scottdube/animatronic-eyes/docs/scope/2026-09-25-wallwart-1V-step.jpg

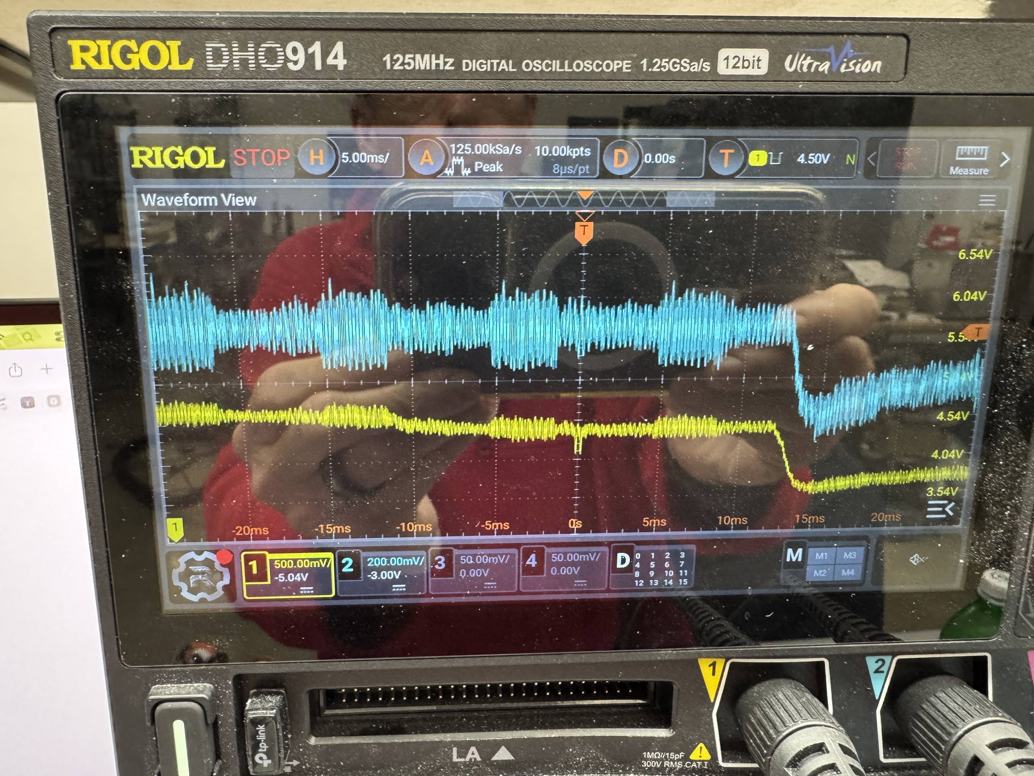
docs/scope/2026-09-25-wallwart-1V-step.jpg
