scottdube/animatronic-eyes/docs/board.jpg

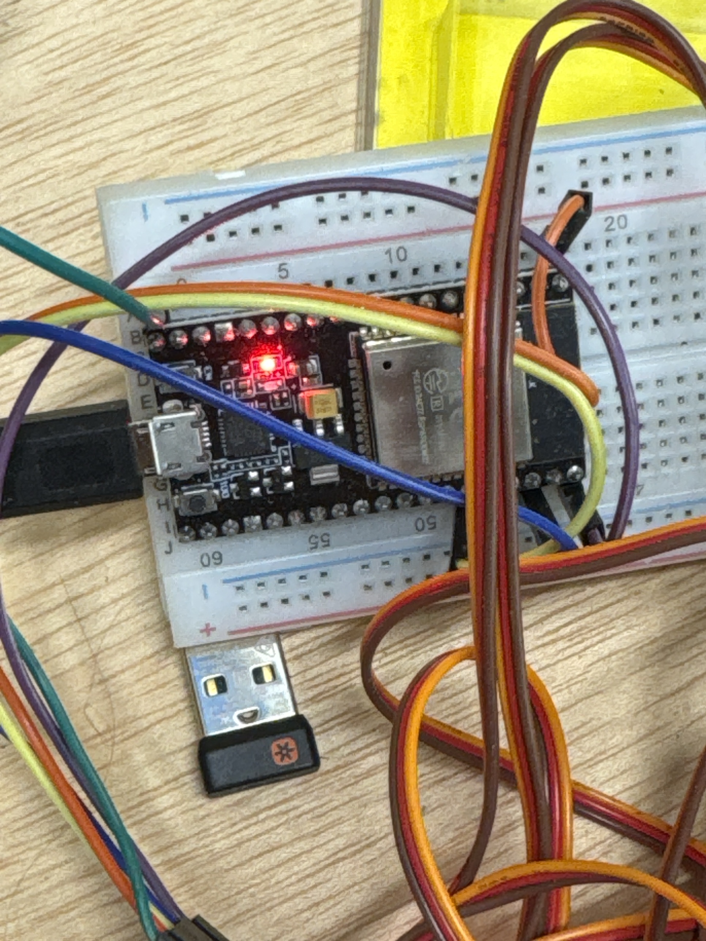
docs/board.jpg
