scottdube/animatronic-eyes/docs/board-pca9685.jpg

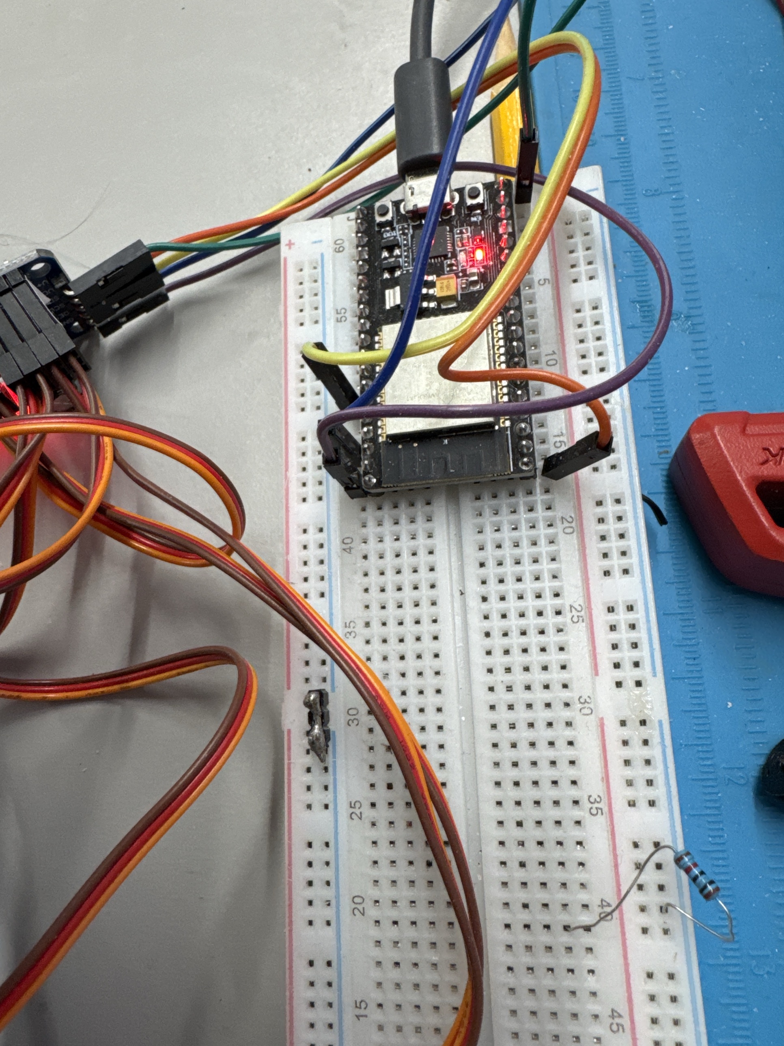
docs/board-pca9685.jpg
