scottdube/animatronic-eyes/docs/controller.jpg

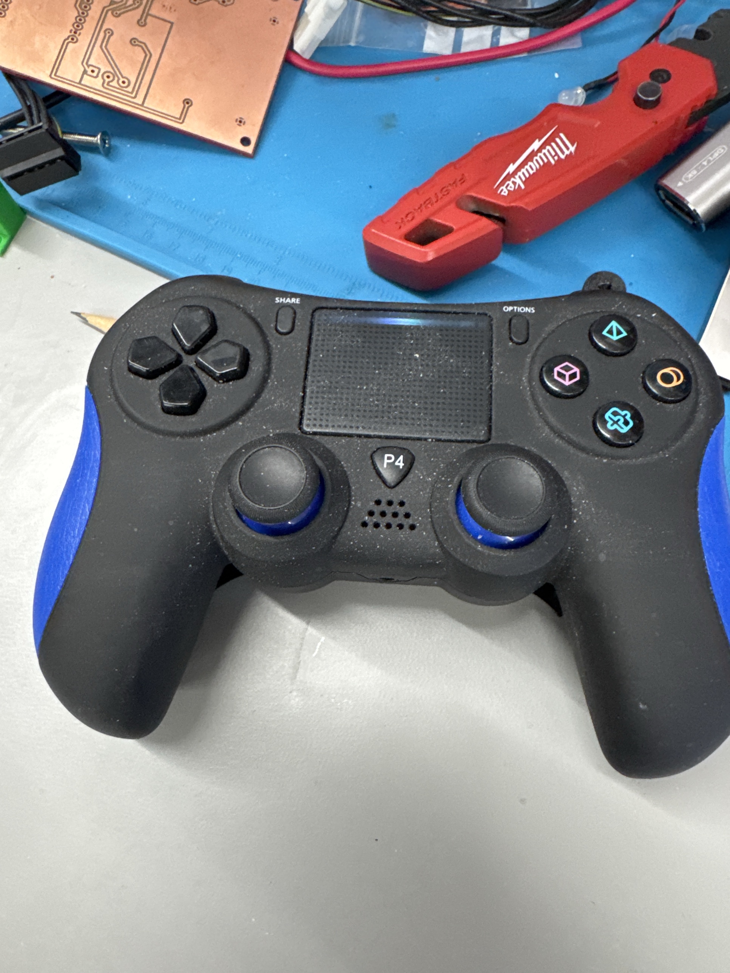
docs/controller.jpg
