scottdube/animatronic-eyes/docs/scope/2026-09-25-wallwart-recovery-ramp.jpg

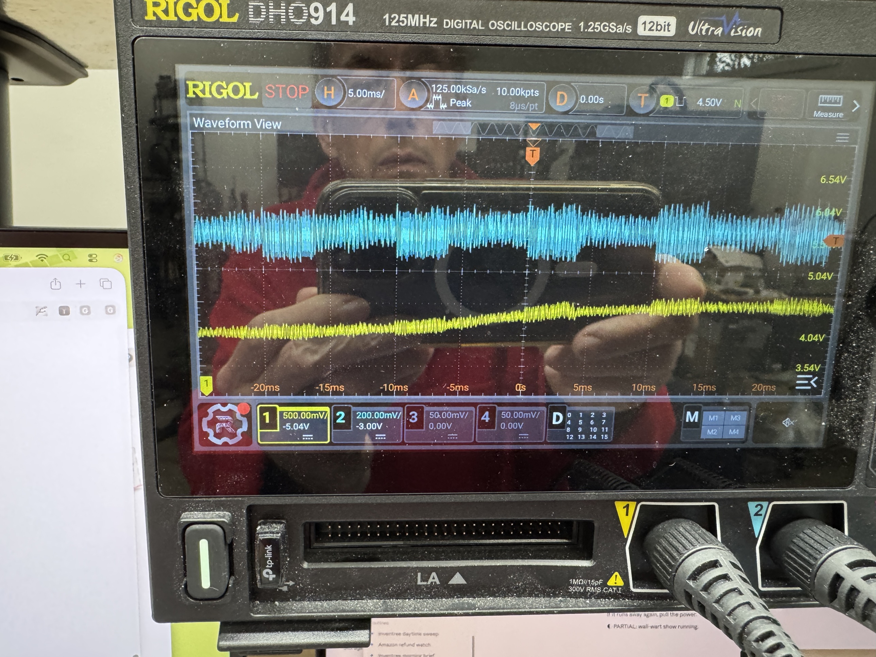
docs/scope/2026-09-25-wallwart-recovery-ramp.jpg
