scottdube/animatronic-eyes/hardware/fitcheck/eyes-carrier-legend-1200dpi.png

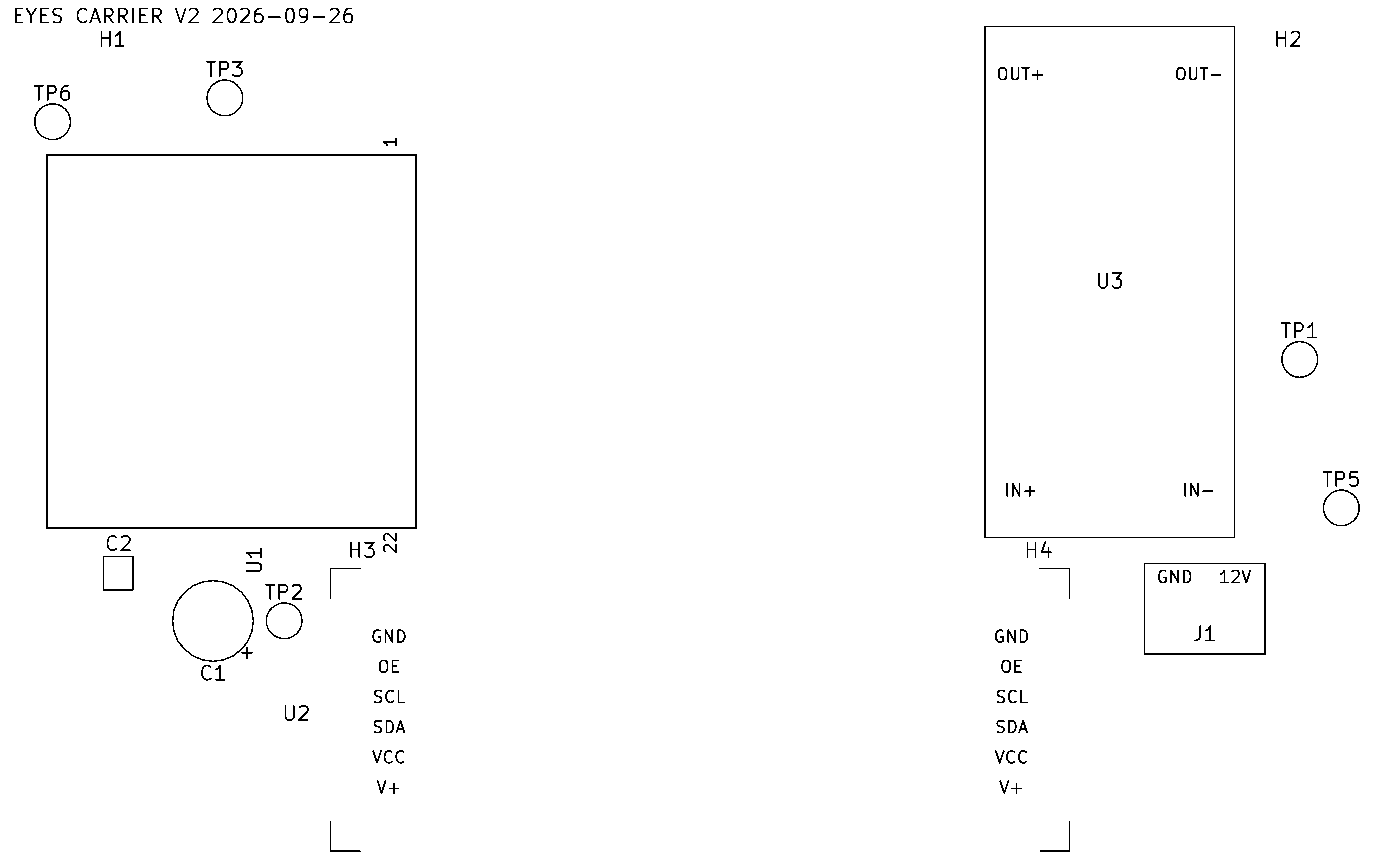
hardware/fitcheck/eyes-carrier-legend-1200dpi.png
