scottdube/animatronic-eyes/hardware/kit-stl/Complete Model.stl

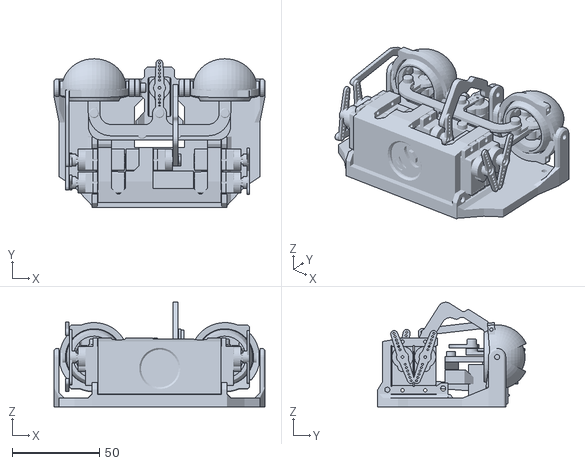
[picture p7: CAD file, 2026-10-13]
hardware/kit-stl/Complete Model.stl
121.0 x 85.2 x 60.0
