scottdube/animatronic-eyes/hardware/native/EyeMech assembly.step

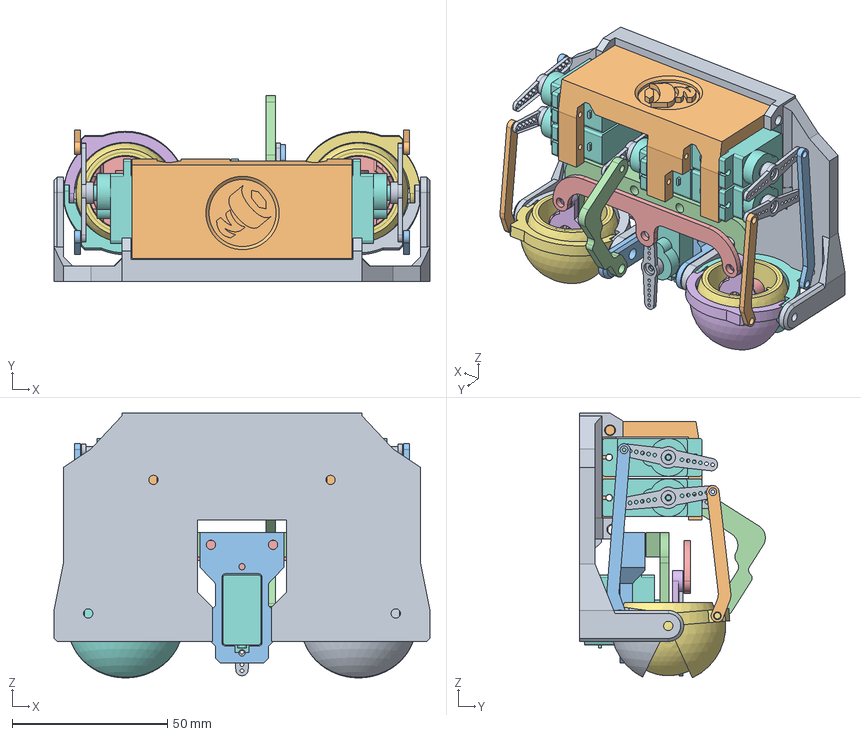
[picture p8: CAD file, 2026-10-14]
hardware/native/EyeMech assembly.step
121.0 x 59.8 x 85.2 mm
