scottdube/animatronic-eyes/docs/animatronic-eyes-pcb.step

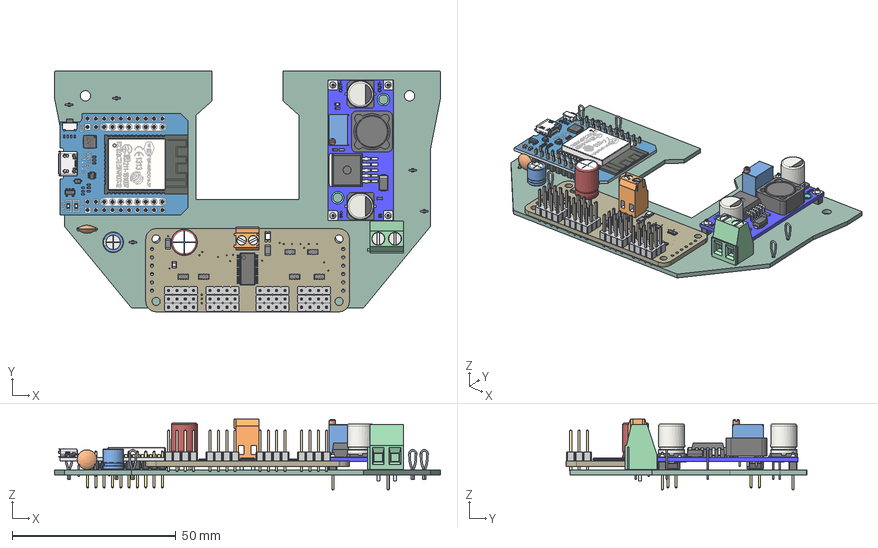
[picture p9: CAD file, 2026-09-26]
docs/animatronic-eyes-pcb.step
117.9 x 73.5 x 21.6 mm
TestPoint_Loop_D2.50mm_Drill1.0mm x 5
C_Disc_D60mm_W25mm_P500mm
C_Elec_8x102
C_Elec_8x103
C_Elec_8x106
C_Elec_8x107
C_0603_1608Metric
C_0603_1608Metric001
D_SMA
a648ce37-9c39-11ed-93f0-dde97e994e83_part
a648ce38-9c39-11ed-93f0-dde97e994e83_part
a648ce39-9c39-11ed-93f0-dde97e994e83_part
a648ce39-9c39-11ed-93f0-dde97e994e83_part001
a648ce39-9c39-11ed-93f0-dde97e994e83_part002
a648ce39-9c39-11ed-93f0-dde97e994e83_part003
a648ce39-9c39-11ed-93f0-dde97e994e83_part004
R_0603_1608Metric
SRR1260
Bourns_3299W
R_0603_1608Metric001
LED_0603_1608Metric
PinHeader_1x01_P254mm_Vertical
PinHeader_1x01_P254mm_Vertical001
PinHeader_1x01_P254mm_Vertical002
PinHeader_1x01_P254mm_Vertical003
CP_Radial_D63mm_P250mm
Wemos ESP32 D1 Mini
ESP WROOM 32
2x10 Pin Male 2,54mm x 2
2x10 Pin Female 2,54mm x 2
Board
Pins x 12
Case x 13
tssop_28 v1
terminal_weidmuller_2way_1667750000 v3
CAP_8X11.5_P3 v1
CAT16-J4 v2 x 6
LTST-C150KGKT_Base
LTST-C150KGKT_AnodeMark
LTST-C150KGKT_AnodeTerminal
LTST-C150KGKT_CathodeTerminal
LTST-C150KGKT_CathodeMark
LTST-C150KGKT_LedDice
LTST-C150KGKT_Lens
LTST-C150KGKT_GreenMark x 2
Pin1Body x 2
Pin2Body x 2
CeramicBody x 2
CoatingBody x 2
Contacts
TerminalBlock_Phoenix_MKDS-1,5-2-5.08_1x02_P5.08mm_Horizontal
carrier_PCB
