scottdube/animatronic-eyes/hardware/carrier/3dmodels/D1_Mini_ESP32_male.stp

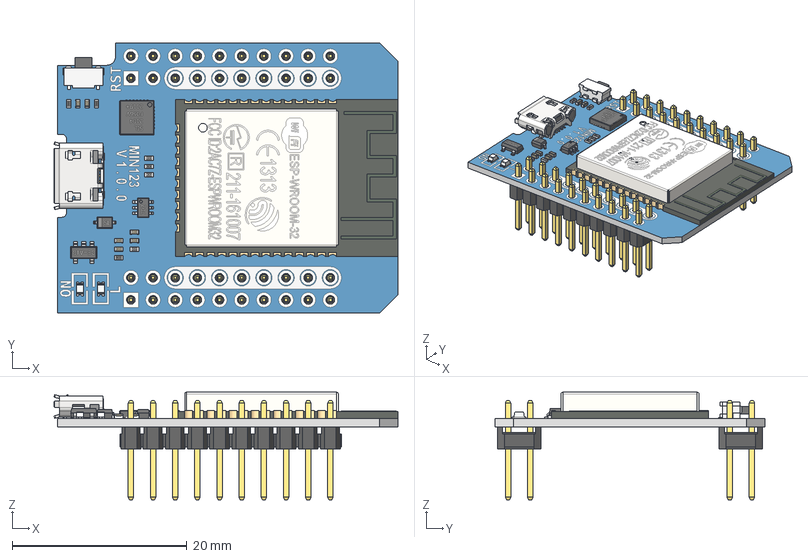
[picture p10: CAD file, 2026-09-26]
hardware/carrier/3dmodels/D1_Mini_ESP32_male.stp
39.4 x 31.0 x 12.3 mm
Pieza4
ESP WROOM 32
_ _ _C010DAAN-RC v1 x 2
zl262-20d_p2-54_l25-9_w5_h8-5 x 2
