scottdube/animatronic-eyes/hardware/carrier/outline.dxf

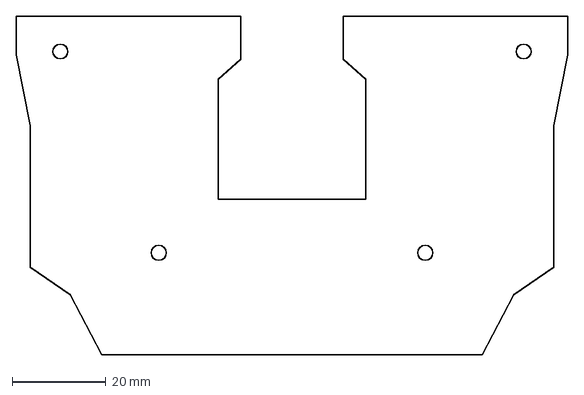
[picture p11: CAD file, 2026-09-25]
hardware/carrier/outline.dxf
117.9 x 72.3 mm
