scottdube/animatronic-eyes/hardware/kit-stl/from-complete-model/SG90 Horn.stl

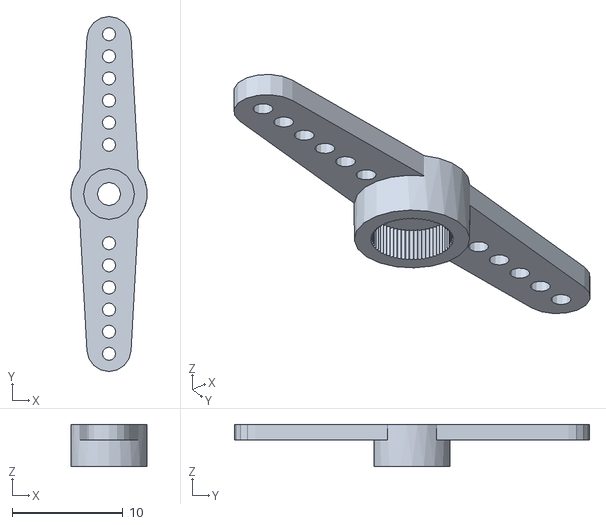
[picture p12: CAD file, 2026-10-14]
hardware/kit-stl/from-complete-model/SG90 Horn.stl
6.90 x 32.1 x 3.80
