scottdube/animatronic-eyes/hardware/carrier/3dmodels/PCA9685.step

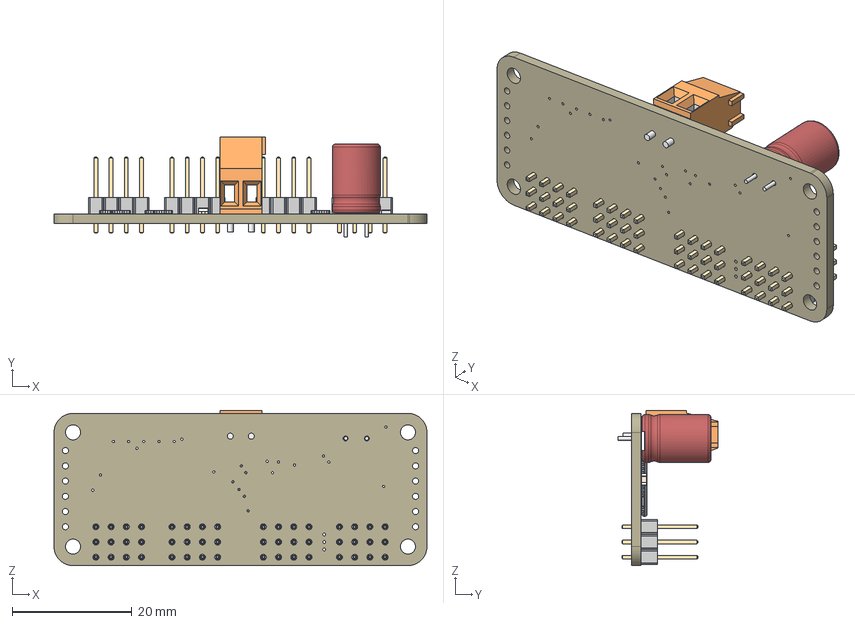
[picture p13: CAD file, 2026-09-26]
hardware/carrier/3dmodels/PCA9685.step
62.2 x 16.6 x 25.9 mm
Board
Pins x 12
Case x 12
tssop_28
terminal_weidmuller_2way_1667750000
CAP_8X11.5_P3
CAT16-J4 x 6
LTST-C150KGKT_Base
LTST-C150KGKT_AnodeMark
LTST-C150KGKT_AnodeTerminal
LTST-C150KGKT_CathodeTerminal
LTST-C150KGKT_CathodeMark
LTST-C150KGKT_LedDice
LTST-C150KGKT_Lens
LTST-C150KGKT_GreenMark x 2
Pin1Body x 2
Pin2Body x 2
CeramicBody x 2
CoatingBody x 2
Case_1
Contacts
