scottdube/animatronic-eyes/hardware/kit-stl/from-complete-model/SG90.stl

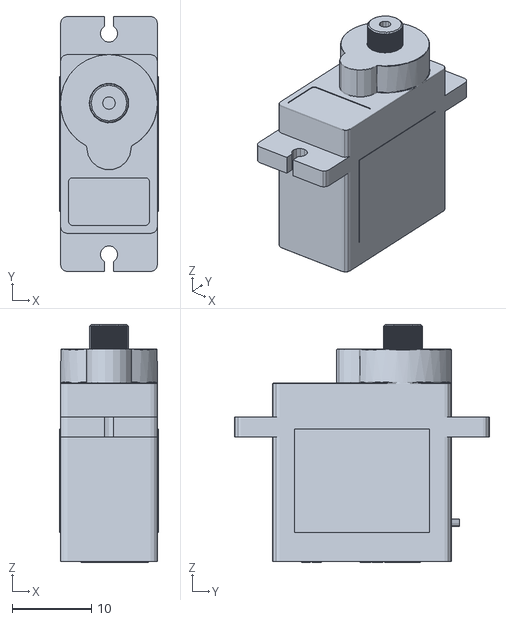
[picture p14: CAD file, 2026-10-14]
hardware/kit-stl/from-complete-model/SG90.stl
12.4 x 32.1 x 30.0
