scottdube/animatronic-eyes/(list of files, cad)

Other CAD files:
hardware/kit-f3d/Bottom Left Lid.f3d
hardware/kit-f3d/Bottom Lid Link (x2).f3d
hardware/kit-f3d/Bottom Right Lid.f3d
hardware/kit-f3d/Eye Adaptor (x2).f3d
hardware/kit-f3d/Eye Holder.f3d
hardware/kit-f3d/Fork (x2).f3d
hardware/kit-f3d/Main Base.f3d
hardware/kit-f3d/PlaceHolder Eye (x2).f3d
hardware/kit-f3d/Servo Block.f3d
hardware/kit-f3d/Sub Base.f3d
hardware/kit-f3d/Three-Point Connector.f3d
hardware/kit-f3d/Top Left Lid.f3d
hardware/kit-f3d/Top Lid Link (x2).f3d
hardware/kit-f3d/Top Right Lid.f3d
hardware/kit-f3d/Y-Arm.f3d
hardware/native/Bottom Left Lid native.f3d
hardware/native/Bottom Lid Link native.f3d
hardware/native/Bottom Right Lid native.f3d
hardware/native/Eye Adaptor native.f3d
hardware/native/Eye Holder native.f3d
hardware/native/Fork native.f3d
hardware/native/Main Base native.f3d
hardware/native/PlaceHolder Eye native.f3d
hardware/native/SG90 Horn native.f3d
hardware/native/SG90 native.f3d
hardware/native/Servo Block native.f3d
hardware/native/Sub Base native.f3d
hardware/native/Three-Point Connector native.f3d
hardware/native/Top Left Lid native.f3d
hardware/native/Top Lid Link native.f3d
hardware/native/Top Right Lid native.f3d
hardware/native/Y-Arm native.f3d
