scottdube/animatronic-eyes/hardware/carrier/carrier.kicad_pcb

## KiCad design hardware/carrier/carrier.kicad_pcb (2026-09-26)

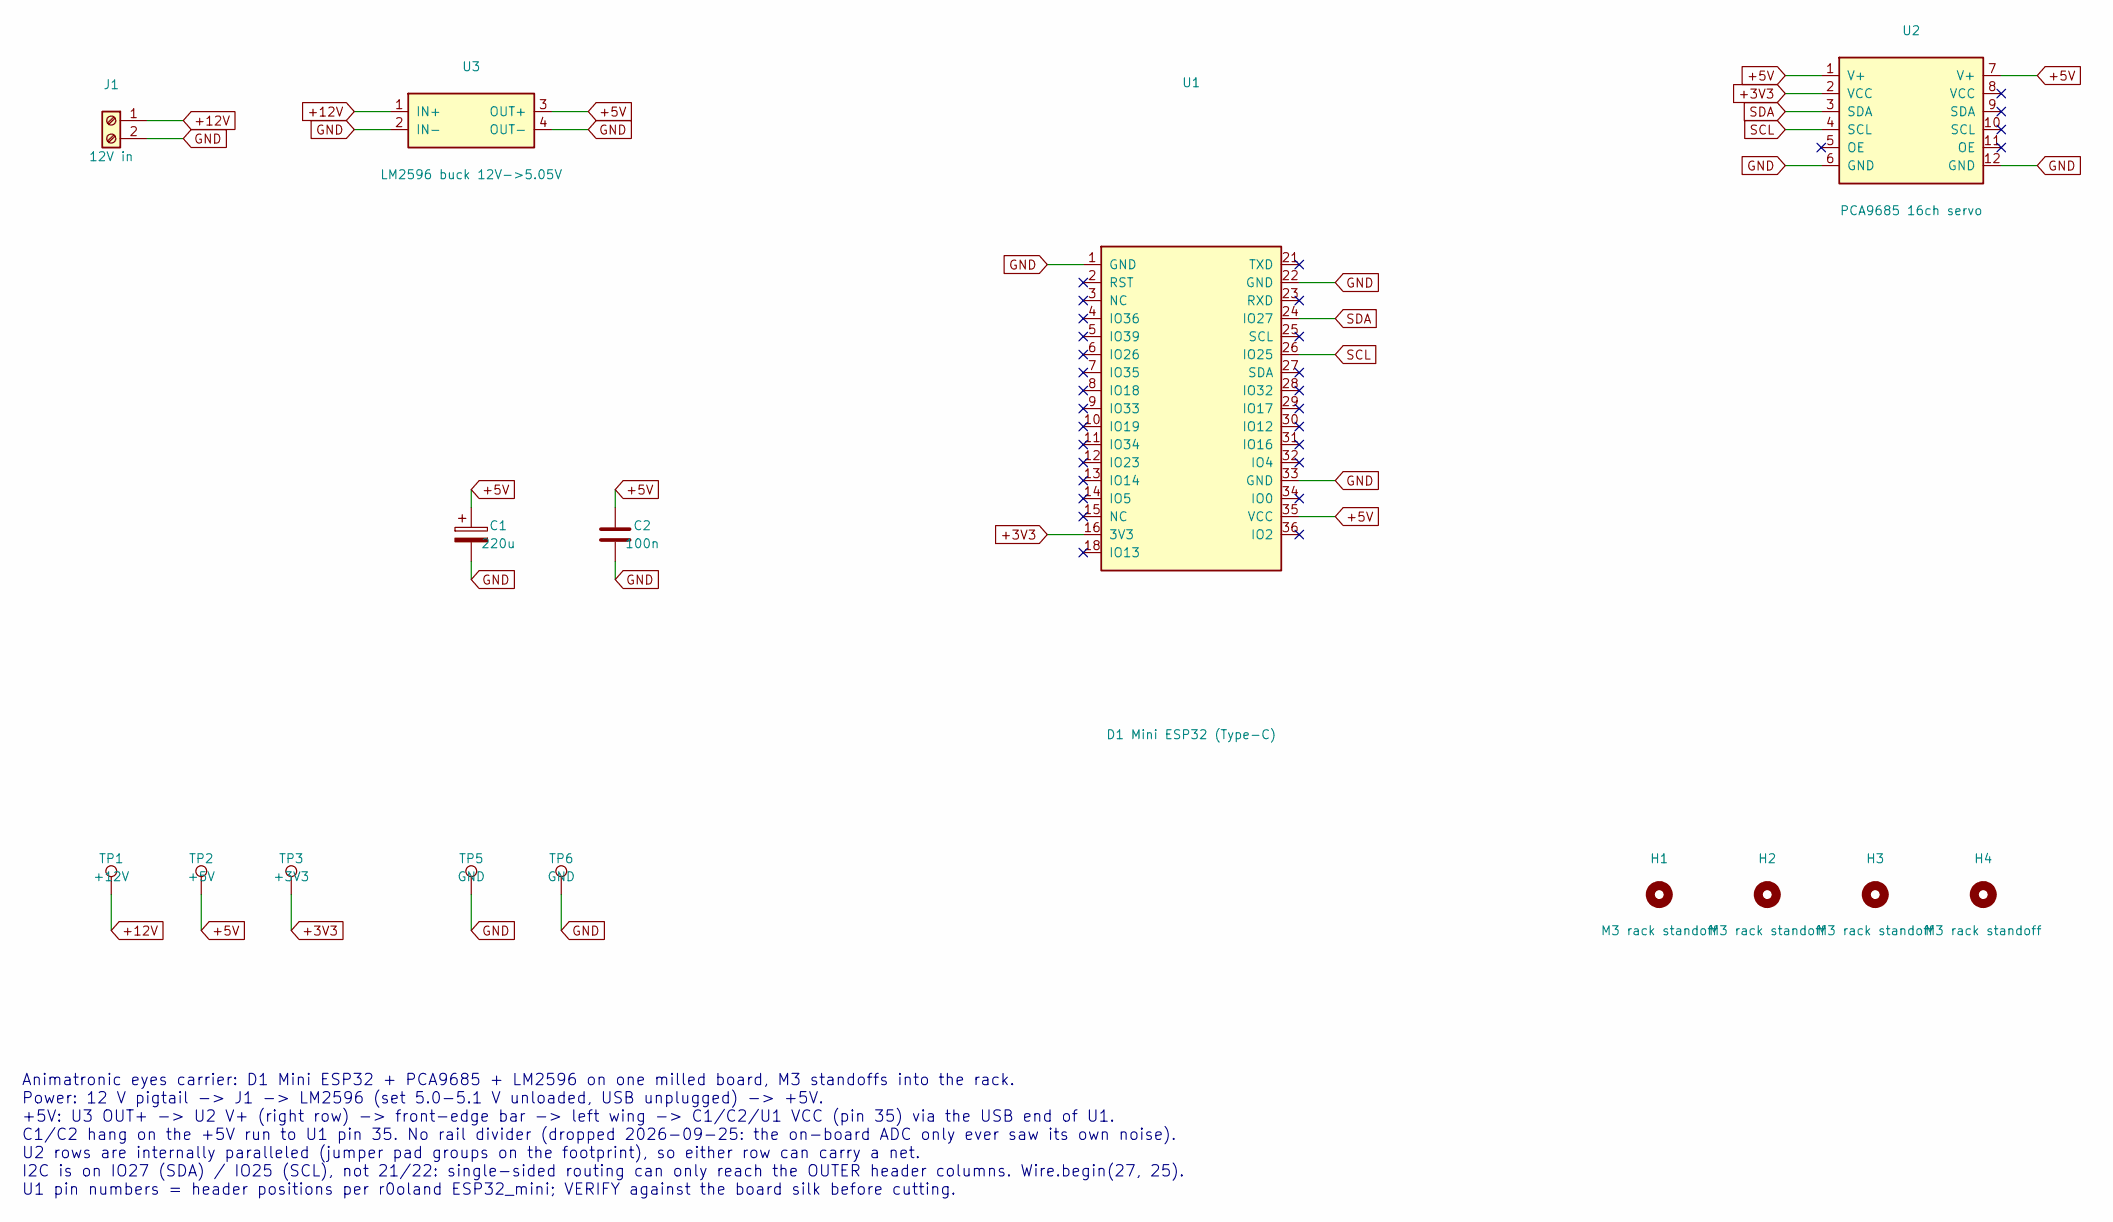
[picture p16: schematic carrier.kicad_sch, Animatronic eyes carrier]

Parts:
C1: 220u; CP_Radial_D6.3_P2.5
C2: 100n; C_Disc_P5.08
H1, H2, H3, H4: M3 rack standoff; MountingHole_M3_3.175
J1: 12V in; KF301_1x02_P5.08
TP1: +12V; TestPoint_THT_D2.2_1.181
TP2: +5V; TestPoint_THT_D2.2_1.181
TP3: +3V3; TestPoint_THT_D2.2_1.181
TP5, TP6: GND; TestPoint_THT_D2.2_1.181
U1: D1 Mini ESP32 (Type-C); D1_Mini_ESP32_THT
U2: PCA9685 16ch servo; PCA9685_Adafruit_Module
U3: LM2596 buck 12V->5.05V; LM2596_Module

Connections:
+3V3: TP3.1, U1.16 (3V3), U2.2 (VCC)
+5V: C1.1, C2.1, TP2.1, U1.35 (VCC), U2.1 (V+), U2.7 (V+), U3.3 (OUT+)
+12V: J1.1, TP1.1, U3.1 (IN+)
GND: C1.2, C2.2, J1.2, TP5.1, TP6.1, U1.1 (GND), U1.22 (GND), U1.33 (GND), U2.6 (GND), U2.12 (GND), U3.2 (IN-), U3.4 (OUT-)
SCL: U1.26 (IO25), U2.4 (SCL)
SDA: U1.24 (IO27), U2.3 (SDA)

Notes on the sheet:
Animatronic eyes carrier: D1 Mini ESP32 + PCA9685 + LM2596 on one milled board, M3 standoffs into the rack. Power: 12 V pigtail -> J1 -> LM2596 (set 5.0-5.1 V unloaded, USB unplugged) -> +5V. +5V: U3 OUT+ -> U2 V+ (right row) -> front-edge bar -> left wing -> C1/C2/U1 VCC (pin 35) via the USB end o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

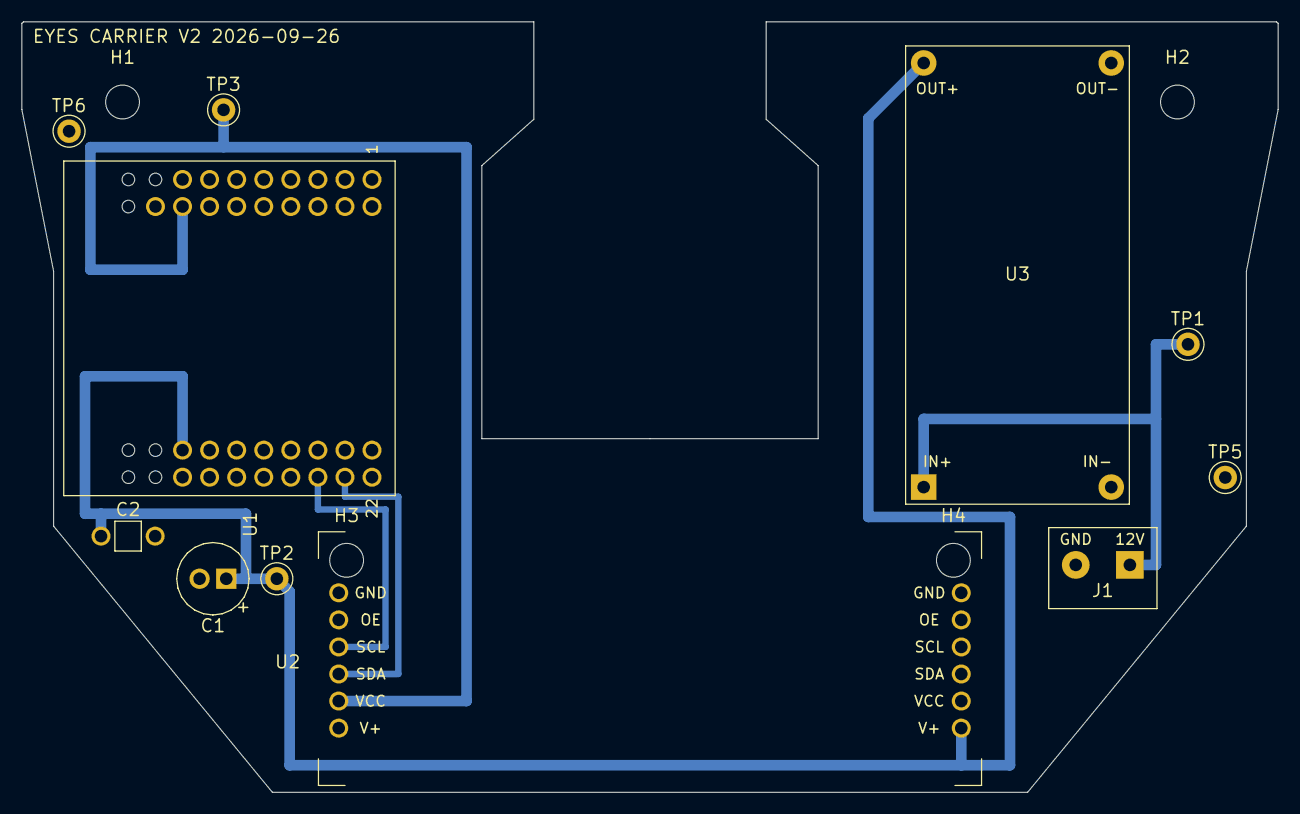
[picture p17: board carrier.kicad_pcb from above]

Board: 2 copper layers, 117.9 x 72.3 mm, 15 parts (0 on the bottom side), 6 nets.
