scottdube/animatronic-eyes/firmware/Low_Tier_Code/Low_Tier_Code.ino

//  Nilheim Mechatronics Simplified Eye Mechanism Code
//  Make sure you have the Adafruit servo driver library installed >>>>> https://github.com/adafruit/Adafruit-PWM-Servo-Driver-Library
//  X-axis joystick pin: A1
//  Y-axis joystick pin: A0
//  Trim potentiometer pin: A2
//  Button pin: 2

 
#include <Wire.h>
#include <Adafruit_PWMServoDriver.h>

Adafruit_PWMServoDriver pwm = Adafruit_PWMServoDriver();

#define SERVOMIN  140 // this is the 'minimum' pulse length count (out of 4096)
#define SERVOMAX  520 // this is the 'maximum' pulse length count (out of 4096)

// our servo # counter
uint8_t servonum = 0;

int xval;
int yval;

int lexpulse;
int rexpulse;

int leypulse;
int reypulse;

int uplidpulse;
int lolidpulse;
int altuplidpulse;
int altlolidpulse;

int trimval;

const int analogInPin = A0;
int sensorValue = 0;
int outputValue = 0;
int switchval = 0;

void setup() {
  Serial.begin(9600);
  Serial.println("8 channel Servo test!");
  pinMode(analogInPin, INPUT);
  pinMode(2, INPUT);
 
  pwm.begin();
  
  pwm.setPWMFreq(60);  // Analog servos run at ~60 Hz updates

  delay(10);
}

// you can use this function if you'd like to set the pulse length in seconds
// e.g. setServoPulse(0, 0.001) is a ~1 millisecond pulse width. its not precise!
void setServoPulse(uint8_t n, double pulse) {
  double pulselength;
  
  pulselength = 1000000;   // 1,000,000 us per second
  pulselength /= 60;   // 60 Hz
  Serial.print(pulselength); Serial.println(" us per period"); 
  pulselength /= 4096;  // 12 bits of resolution
  Serial.print(pulselength); Serial.println(" us per bit"); 
  pulse *= 1000000;  // convert to us
  pulse /= pulselength;
  Serial.println(pulse);

}

void loop() {

  xval = analogRead(A1);
    lexpulse = map(xval, 0,1023, 220, 440);
    rexpulse = lexpulse;

    switchval = digitalRead(2);
    
    
  yval = analogRead(A0);
    leypulse = map(yval, 0,1023, 250, 500);
    reypulse = map(yval, 0,1023, 400, 280);

  trimval = analogRead(A2);
    trimval=map(trimval, 320, 580, -40, 40);
     uplidpulse = map(yval, 0, 1023, 400, 280);
        uplidpulse -= (trimval-40);
          uplidpulse = constrain(uplidpulse, 280, 400);
     altuplidpulse = 680-uplidpulse;

     lolidpulse = map(yval, 0, 1023, 410, 280);
       lolidpulse += (trimval/2);
         lolidpulse = constrain(lolidpulse, 280, 400);      
     altlolidpulse = 680-lolidpulse;
 
    
      pwm.setPWM(0, 0, lexpulse);
      pwm.setPWM(1, 0, leypulse);


      if (switchval == HIGH) {
      pwm.setPWM(2, 0, 400);
      pwm.setPWM(3, 0, 240);
      pwm.setPWM(4, 0, 240);
      pwm.setPWM(5, 0, 400);
      }
      else if (switchval == LOW) {
      pwm.setPWM(2, 0, uplidpulse);
      pwm.setPWM(3, 0, lolidpulse);
      pwm.setPWM(4, 0, altuplidpulse);
      pwm.setPWM(5, 0, altlolidpulse);
      }



          Serial.println(trimval);
          Serial.println(xval);
          Serial.println(yval);
          Serial.println (switchval);
      
  delay(5);

}
