scottdube/animatronic-eyes/firmware/EyeMech_PS4/Scenes.cpp

#include "Scenes.h"
#include "EyeSettings.h"
#include <PS4Controller.h>
#include <esp_partition.h>
#include <math.h>
#include <Preferences.h>

void setLidPreset(int idx);  // the sketch's lid preset (0 closed .. 3 wide)

// ---- state ----------------------------------------------------------------
// Everyday use (Scott, 2026-09-25): walk in, 30 s later the eyes wake and do a short
// show, then sleep; the servos are loud, so they must NOT run the whole time he is in
// the lab. Another show comes on a return after the lab was empty a while, and every
// showEvery minutes while he is there. Extended play is on demand (HA voice or page).
static SceneMode mode = M_REST, shownMode = (SceneMode)-1, prevMode = M_REST;
static uint32_t lastTakeover = 0;
static bool prevTri = false, prevCir = false, prevShare = false;

static uint32_t idleUntil = 0;  // end of the current show
static bool playThenIdle = false;

static bool present = false, everPresent = false;
static uint32_t emptySince = 0;
static bool showPending = false;  // an arrival show waiting out arriveDelay
static uint32_t showAt = 0;
static uint32_t nextPeriodic = 0;  // 0 = none (nobody present, or showEvery 0)
static bool sleepAfterHands = false;  // the controller was let go: sleep after handsOffSecs
static uint32_t sleepSince = 0;
static bool wasConnected = false;
// Look test (page buttons): hold the eyes at a full stick position while resting, to
// check the end stops and calibration. Anything else that happens clears it.
static bool looking = false;
// Service (page button): hold still for work on the mechanism. Lids closed (the reference
// the horns were seated to), eyes at center, servos powered, and nothing starts: no shows,
// no controller, no sleep (sleep goes limp and a limp servo turns by hand). Kept in NVS
// so a power cycle mid-job comes back in service, not into the power-up show.
static bool serviceSaved() {
  Preferences p;
  bool on = p.begin("scene", true) && p.getBool("service", false);
  p.end();
  return on;
}
static void serviceStore(bool on) {
  Preferences p;
  if (p.begin("scene", false)) {
    p.putBool("service", on);
    p.end();
  }
}
static int lookSx = 0, lookSy = 0;
// Noise test (page buttons, 2026-10-14): one fixed motion repeated for TEST_MS, so a sound meter
// can compare runs and find which source is loud. One servo moves and the other five get no pulses
// (they can't hum); "all" moves everything; "hold" pulses all six at rest without moving (holding
// buzz). Out half travel and back, eased or sudden (as fast as the servo goes), with a pause at
// each end. Anything else that happens ends it, and no show starts while it runs.
static int testCh = -1;  // -1 off, 0-5 one servo, 6 all, 7 hold
static bool testSudden = false;
static uint32_t testAt = 0;
static const uint32_t TEST_MS = 30000, TEST_MOVE = 800, TEST_DWELL = 700;

// ---- alive idle generator --------------------------------------------------
// Gaze is picked in the kit's 0..1023 units as an offset from the rest
// position, NOT in stick units: with the eyes parked low the stick's upper half
// covers ~3x the travel of its lower half, so even stick targets looked up
// most of the time and the pupils disappeared (seen by Scott 2026-09-24).
static const float IDLE_X_MAX = 400, IDLE_Y_MAX = 200;  // offsets at glanceRange 100%
static float gx = 0, gy = 0, tx = 0, ty = 0;
static int idleLid = 75;          // % open; normal, with the odd squint or wide look
static uint32_t idleLidUntil = 0;
static uint32_t nextGlance = 0, nextDrift = 0, nextBlink = 0, blinkEnd = 0, secondBlink = 0;
static uint32_t lastIdleUpdate = 0;
// A timed glance (glanceMs > 0): from (mx0,my0) toward the target it started for. A new target,
// or the gaze moved by something else (a set piece, a reset), starts a fresh move from where it is.
static float mx0 = 0, my0 = 0, mtx = 0, mty = 0;
static uint32_t moveAt = 0;
static bool moveStale = true;
// Set pieces inside a show (Scott, 2026-09-25). Times in ms.
// Wake: a show that starts from sleep opens wide and looks far to his left first.
static const uint32_t WAKE_MS = 2500;
static uint32_t wakeUntil = 0;
// Every 30-50 s one of these, never the same twice running:
//  slow squint: wide, close slowly to squint, then a slow look side to side;
//  eye roll: up and over from one side to the other, brisk but not a saccade;
//  circle: the pupils run once around the edge of their travel.
enum Piece { P_NONE, P_SQUINT, P_ROLL, P_CIRCLE };
static const uint32_t SQ_OPEN = 600, SQ_CLOSE = 3000, SQ_PAN = 6000, SQ_BACK = 600;
static const uint32_t MOVE_IN = 400, ROLL_MS = 1300, CIRCLE_MS = 2400, MOVE_OUT = 500;
static Piece piece = P_NONE, lastPiece = P_NONE;
static uint32_t pieceAt = 0;    // start of the running piece, or when the next one starts
static int pieceDir = 1;        // which way a roll or circle goes
// Winks: now and then one eye closes, either eye.
static const uint32_t WINK_MS = 400;
static uint32_t nextWink = 0, winkEnd = 0;
static int winkEye = 0;

static float frand() { return (float)esp_random() / 4294967295.0f; }  // 0..1

static uint32_t nextBlinkDelay() {
  if (settings.blinkRate <= 0) return 0xFFFFFFFF / 2;
  float mean = 60000.0f / settings.blinkRate;
  float d = -logf(1.0f - frand() * 0.999f) * mean;  // exponential: Poisson blinks
  return (uint32_t)max(800.0f, d);
}

// Inverse of the sketch's stickToAdc (INVERT_X/Y false): an offset from `center`
// in 0..1023 units to the stick value that lands there.
static int adcToStick(float off, int center) {
  float v = off >= 0 ? off * 127.0f / max(1, 1023 - center) : off * 128.0f / max(1, center);
  return constrain((int)lroundf(v), -128, 127);
}

static uint32_t randMs(uint32_t lo, uint32_t hi) { return lo + (uint32_t)(frand() * (hi - lo)); }

static void idleReset(uint32_t now, bool fromSleep) {
  tx = ty = 0;
  wakeUntil = fromSleep ? now + WAKE_MS : now;
  piece = P_NONE;
  pieceAt = wakeUntil + randMs(20000, 40000);
  nextWink = wakeUntil + randMs(15000, 45000);
  winkEnd = 0;
  nextGlance = now + 300;
  nextDrift = now + 400;
  nextBlink = now + nextBlinkDelay();
  blinkEnd = secondBlink = 0;
  idleLidUntil = 0;
  lastIdleUpdate = now;
  moveStale = true;
}

// Far to his left: + x is his left (measured 2026-09-25), kept a little off the end stop
static float farLeft() { return 1023 - 40 - restX(); }

// Stick space (-128..127, full travel each way) to the 0..1023 offset gx/gy use
static float stickToOff(float v, int center) { return v >= 0 ? v * (1023 - center) / 127.0f : v * center / 128.0f; }
static float smoothstep(float t) { t = constrain(t, 0.0f, 1.0f); return t * t * (3 - 2 * t); }
// Minimum jerk: zero speed AND zero acceleration at both ends, so the gear train isn't jolted
static float smootherstep(float t) { t = constrain(t, 0.0f, 1.0f); return t * t * t * (t * (t * 6 - 15) + 10); }

// Ease the gaze toward a point on the edge of travel: angle a (0 = his left, 90 = up), r of full travel
static void edgeTarget(float a, float r, float &x, float &y) {
  float rad = a * (float)M_PI / 180.0f;
  x = stickToOff(r * 127.0f * cosf(rad), restX());
  y = stickToOff(r * 127.0f * sinf(rad), restY());
}
static void easeTo(float x, float y, float dt, float tau) {
  float k = 1.0f - expf(-dt / tau);
  gx += (x - gx) * k;
  gy += (y - gy) * k;
}

static void endPiece(uint32_t now) {
  lastPiece = piece;
  piece = P_NONE;
  tx = ty = 0;
  pieceAt = now + randMs(30000, 50000);
  nextGlance = nextBlink = now + 300;
}

// The set pieces; true = this frame is theirs and ordinary idle waits
static bool setPiece(uint32_t now, Frame &f) {
  float dt = (float)(now - lastIdleUpdate);
  if (now < wakeUntil) {  // wake: wide, eyes swing far left and hold
    easeTo(farLeft(), 0, dt, 150);
    f.lid = settings.lidWide;
    return true;
  }
  if (piece == P_NONE) {
    if (now < pieceAt) return false;
    do piece = (Piece)(1 + (int)(frand() * 3) % 3); while (piece == lastPiece);
    pieceDir = frand() < 0.5f ? 1 : -1;
    pieceAt = now;
  }
  uint32_t t = now - pieceAt;
  f.lid = settings.lidNormal;
  if (piece == P_SQUINT) {
    float R = settings.glanceRange / 100.0f * IDLE_X_MAX;
    if (t < SQ_OPEN) {  // wide, eyes back to center
      easeTo(0, 0, dt, 150);
      f.lid = settings.lidWide;
    } else if ((t -= SQ_OPEN) < SQ_CLOSE) {  // slowly down to squint
      f.lid = settings.lidWide + (settings.lidSquint - settings.lidWide) * (float)t / SQ_CLOSE;
    } else if ((t -= SQ_CLOSE) < SQ_PAN) {  // one slow sweep: his left, across to his right, back
      gx = R * sinf(2 * (float)M_PI * t / SQ_PAN);
      f.lid = settings.lidSquint;
    } else if ((t -= SQ_PAN) >= SQ_BACK) {
      endPiece(now);
      return false;
    }
    return true;
  }
  // Roll: from just below one side, up over the top, to just below the other side.
  // Circle: once around the edge of travel, starting and ending at one side.
  float a0 = pieceDir > 0 ? -20 : 200, sweep = piece == P_ROLL ? 220 : 360, r = piece == P_ROLL ? 0.85f : 0.95f;
  uint32_t T = piece == P_ROLL ? ROLL_MS : CIRCLE_MS;
  float x, y;
  if (t < MOVE_IN) {  // get to the start point
    edgeTarget(a0, r, x, y);
    easeTo(x, y, dt, 80);
  } else if ((t -= MOVE_IN) < T) {
    // A roll eases in and out; a circle runs at an even pace
    float u = piece == P_ROLL ? smoothstep((float)t / T) : (float)t / T;
    edgeTarget(a0 + pieceDir * sweep * u, r, gx, gy);
  } else if ((t -= T) < MOVE_OUT) {
    easeTo(0, 0, dt, 100);
  } else {
    endPiece(now);
    return false;
  }
  return true;
}

static Frame idleFrame(uint32_t now) {
  Frame f;
  if (setPiece(now, f)) {
    lastIdleUpdate = now;
    moveStale = true;
    blinkEnd = secondBlink = winkEnd = 0;
    f.sx = adcToStick(gx, restX());
    f.sy = adcToStick(gy, restY());
    f.blink = false;
    return f;
  }
  if (now >= nextGlance) {
    bool big = frand() < 0.30f;
    float r = settings.glanceRange / 100.0f * (big ? 1.0f : 0.3f);
    tx = (frand() * 2 - 1) * r * IDLE_X_MAX;
    ty = (frand() * 2 - 1) * r * IDLE_Y_MAX;  // people glance sideways more than up/down
    nextGlance = now + (uint32_t)(settings.glanceTenths * 100 * (0.5f + frand()));
    if (big && frand() < 0.25f) nextBlink = now;  // a big glance often comes with a blink
    if (now >= idleLidUntil) {  // now and then a wide look (with a big glance) or a squint
      float r2 = frand();
      if (big && r2 < 0.25f) {
        idleLid = settings.lidWide;
        idleLidUntil = now + 800 + (uint32_t)(frand() * 1200);
      } else if (r2 < 0.10f) {
        idleLid = settings.lidSquint;
        idleLidUntil = now + 1500 + (uint32_t)(frand() * 2500);
      } else {
        idleLid = settings.lidNormal;
      }
    }
  }
  bool moving = settings.glanceMs > 0 && !moveStale && now - moveAt < (uint32_t)settings.glanceMs;
  if (settings.drift && now >= nextDrift && !moving) {  // small wander between glances, never mid-glance
    tx += (frand() * 2 - 1) * 10;
    ty += (frand() * 2 - 1) * 10;
    nextDrift = now + 300 + (uint32_t)(frand() * 400);
  }
  float dt = (float)(now - lastIdleUpdate);
  lastIdleUpdate = now;
  if (settings.glanceMs <= 0) {
    float a = 1.0f - expf(-dt / 60.0f);  // saccade: ~60 ms time constant
    gx += (tx - gx) * a;
    gy += (ty - gy) * a;
    moveStale = true;
  } else {
    if (moveStale || tx != mtx || ty != mty) {
      mx0 = gx, my0 = gy, mtx = tx, mty = ty, moveAt = now;
      moveStale = false;
    }
    float u = smootherstep((float)(now - moveAt) / settings.glanceMs);
    gx = mx0 + (tx - mx0) * u;
    gy = my0 + (ty - my0) * u;
  }

  if (now >= nextBlink) {
    blinkEnd = now + 150;
    if (frand() < 0.15f) secondBlink = now + 300;  // double blink
    nextBlink = now + nextBlinkDelay();
  }
  if (secondBlink && now >= secondBlink) {
    blinkEnd = now + 150;
    secondBlink = 0;
  }
  if (now >= nextWink && now >= blinkEnd) {  // a wink, either eye, a few per show
    winkEye = frand() < 0.5f ? 1 : 2;
    winkEnd = now + WINK_MS;
    nextWink = now + randMs(25000, 60000);
  }
  f.sx = adcToStick(gx, restX());
  f.sy = adcToStick(gy, restY());
  f.blink = now < blinkEnd;
  f.wink = now < winkEnd ? winkEye : 0;
  f.lid = now < idleLidUntil ? idleLid : settings.lidNormal;
  return f;
}

// ---- recording store: the spare 128 KB "spiffs" data partition, raw ----------
// [0..255] header (written last), then 4-byte frames at 50 Hz from offset 256.
static const uint32_t MAGIC = 0x32524559;  // "EYR2": byte 3 is lid % open (EYR1 was trim)
static const uint32_t FRAME_MS = 20, HDR = 256;
struct Header {
  uint32_t magic, frames, frameMs;
};
static const esp_partition_t *part = nullptr;
static uint32_t storedFrames = 0;

static uint8_t wbuf[256];
static size_t wlen = 0;
static uint32_t woff = HDR, recFrames = 0, recNext = 0;

static uint8_t rbuf[256];
static int32_t rbase = -1;
static uint32_t playStart = 0;

static void setLightBar(SceneMode m) {
  if (!PS4.isConnected()) return;
  uint8_t r = 0, g = 0, b = 0, on = 0, off = 0;
  switch (m) {
    case M_IDLE: g = 255; break;
    case M_PLAY: r = 255; b = 255; break;
    case M_RECORD: r = 255; on = off = 25; break;  // flashing, not color alone
    case M_SLEEP: b = 16; break;
    default: b = 255; break;
  }
  PS4.setLed(r, g, b);
  PS4.setFlashRate(on, off);
  PS4.sendToController();
}

static void finishRecording() {
  if (wlen) {
    memset(wbuf + wlen, 0xFF, sizeof wbuf - wlen);
    esp_partition_write(part, woff, wbuf, sizeof wbuf);
    woff += sizeof wbuf;
    wlen = 0;
  }
  Header h = {MAGIC, recFrames, FRAME_MS};
  esp_partition_write(part, 0, &h, sizeof h);  // the header area is still erased
  storedFrames = recFrames;
  Serial.printf("Scene: recorded %lu frames (%.1f s)\n", (unsigned long)recFrames, recFrames * FRAME_MS / 1000.0f);
  mode = M_LIVE;
}

static void stopScene() {
  if (mode == M_RECORD) finishRecording();
  mode = M_REST;
}

// Where the eyes go when a show, a playback or the controller is done: asleep, unless
// shows are off altogether (then they rest open as before).
static void endScene() {
  stopScene();
  if (settings.idleMode != 0) mode = M_SLEEP;
}

static bool startShow(uint32_t now, uint32_t secs) {
  if (mode == M_RECORD || settings.idleMode == 0) return false;
  idleReset(now, mode == M_SLEEP);
  idleUntil = now + secs * 1000UL;
  mode = M_IDLE;
  showPending = false;
  sleepAfterHands = false;
  return true;
}

static bool startPlay(uint32_t now, bool thenIdle) {
  if (!storedFrames || mode == M_RECORD) return false;
  playThenIdle = thenIdle;
  playStart = now;
  showPending = false;
  sleepAfterHands = false;
  rbase = -1;
  mode = M_PLAY;
  return true;
}

static bool startRecord() {
  if (!part || !PS4.isConnected()) return false;  // a recording is the controller driving
  Serial.println("Scene: erasing recording store");
  esp_partition_erase_range(part, 0, part->size);  // ~1.3 s; the eyes hold still
  storedFrames = 0;
  wlen = 0;
  woff = HDR;
  recFrames = 0;
  recNext = millis();
  mode = M_RECORD;
  return true;
}

static void recordSample(const Frame &f, uint32_t now) {
  if (now - recNext > 200) recNext = now;  // fell behind (e.g. erase): don't burst
  while ((int32_t)(now - recNext) >= 0) {
    recNext += FRAME_MS;
    wbuf[wlen++] = (uint8_t)(int8_t)f.sx;
    wbuf[wlen++] = (uint8_t)(int8_t)f.sy;
    wbuf[wlen++] = (f.blink ? 1 : 0) | (f.wink & 3) << 1;  // bits 1-2: wink (old recordings: 0)
    wbuf[wlen++] = (uint8_t)f.lid;
    recFrames++;
    if (wlen == sizeof wbuf) {
      esp_partition_write(part, woff, wbuf, sizeof wbuf);
      woff += sizeof wbuf;
      wlen = 0;
      if (woff + sizeof wbuf > part->size) {  // full: ~654 s
        finishRecording();
        return;
      }
    }
  }
}

// Returns false at the end of the recording
static bool playFrame(uint32_t now, Frame &f) {
  uint32_t idx = (now - playStart) / FRAME_MS;
  if (idx >= storedFrames) return false;
  uint32_t off = HDR + idx * 4, base = off & ~255u;
  if ((int32_t)base != rbase) {
    esp_partition_read(part, base, rbuf, sizeof rbuf);
    rbase = base;
  }
  const uint8_t *p = rbuf + (off - base);
  f.sx = (int8_t)p[0];
  f.sy = (int8_t)p[1];
  f.blink = p[2] & 1;
  f.wink = p[2] >> 1 & 3;
  f.lid = constrain((int)p[3], 0, 100);
  return true;
}

// ---- public -----------------------------------------------------------------
void scenesBegin() {
  part = esp_partition_find_first(ESP_PARTITION_TYPE_DATA, ESP_PARTITION_SUBTYPE_DATA_SPIFFS, nullptr);
  if (!part) {
    Serial.println("Scene: no spiffs partition - recording disabled (flash with PartitionScheme=min_spiffs)");
    return;
  }
  Header h;
  esp_partition_read(part, 0, &h, sizeof h);
  if (h.magic == MAGIC && h.frameMs == FRAME_MS && HDR + h.frames * 4 <= part->size) storedFrames = h.frames;
  Serial.printf("Scene: store %lu KB, recording %.1f s\n", (unsigned long)(part->size / 1024),
                storedFrames * FRAME_MS / 1000.0f);
}

// An arrival (or power-up) show: what arriveAction says
static void arrivalShow(uint32_t now) {
  if (settings.arriveAction == 1) startShow(now, settings.showSecs);
  else if (settings.arriveAction == 2 && !startPlay(now, true)) startShow(now, settings.showSecs);
}

// Noise test motion: 0 at rest .. 1 at the far point. Out, pause, back, pause.
static float testPhase(uint32_t t) {
  uint32_t c = t % (2 * (TEST_MOVE + TEST_DWELL));
  bool out = c < TEST_MOVE + TEST_DWELL;
  uint32_t m = out ? c : c - TEST_MOVE - TEST_DWELL;
  if (m >= TEST_MOVE || testSudden) return out ? 1 : 0;
  float e = 0.5f - 0.5f * cosf(PI * m / TEST_MOVE);
  return out ? e : 1 - e;
}

// Eyes from rest to half travel (his left, up); lids from the normal preset to squint, so nothing
// reaches an end stop or the closed seal (both make a servo strain and buzz).
static Frame testFrame(uint32_t now) {
  float p = testCh == 7 ? 0 : testPhase(now - testAt);
  Frame f = {0, 0, false, settings.lidNormal};
  if (testCh == 0 || testCh == 6) f.sx = lroundf(64 * p);
  if (testCh == 1 || testCh == 6) f.sy = lroundf(64 * p);
  if (testCh >= 2 && testCh <= 6) f.lid = lroundf(settings.lidNormal + (settings.lidSquint - settings.lidNormal) * p);
  f.power = testCh <= 5 ? 1 << testCh : 0x3F;
  return f;
}

Frame scenesUpdate(const PadState &pad, const Frame &live, uint32_t now) {
  if (pad.connected && !wasConnected) shownMode = (SceneMode)-1;  // fresh connection: resend the light bar
  wasConnected = pad.connected;

  // Controller: takeover stops any scene; Triangle / Circle / Share are commands
  if (pad.connected && pad.takeover && mode != M_SERVICE) {
    lastTakeover = now;
    showPending = false;  // driving during the arrival wait: no show on top of it
    if (mode == M_IDLE || mode == M_PLAY || mode == M_SLEEP) stopScene();
    if (mode != M_RECORD) mode = M_LIVE;
  }
  bool ctl = pad.connected && mode != M_SERVICE;
  bool tri = ctl && pad.triangle, cir = ctl && pad.circle, sh = ctl && pad.share;
  if (tri && !prevTri) {
    if (mode == M_IDLE) endScene();
    else startShow(now, settings.showSecs);
  }
  if (cir && !prevCir) {
    if (mode == M_PLAY) endScene();
    else startPlay(now, false);
  }
  if (sh && !prevShare) {
    if (mode == M_RECORD) finishRecording();
    else startRecord();
  }
  prevTri = tri;
  prevCir = cir;
  prevShare = sh;
  if (mode == M_RECORD && !pad.connected) finishRecording();

  // Timers
  if (mode == M_IDLE && (settings.idleMode == 0 || (int32_t)(now - idleUntil) >= 0)) endScene();
  if (mode == M_LIVE && now - lastTakeover > 3000) {
    mode = M_REST;
    sleepAfterHands = settings.idleMode != 0;
  }
  if (sleepAfterHands && mode == M_REST && now - lastTakeover >= settings.handsOffSecs * 1000UL) {
    sleepAfterHands = false;
    mode = M_SLEEP;
  }
  if (testCh >= 0 && now - testAt >= TEST_MS) {  // done: go quiet like the end of a show
    testCh = -1;
    endScene();
  }
  bool waiting = (mode == M_REST && testCh < 0) || mode == M_SLEEP;
  if (showPending && (int32_t)(now - showAt) >= 0) {
    showPending = false;
    if (waiting) arrivalShow(now);
  }
  if (nextPeriodic && (int32_t)(now - nextPeriodic) >= 0) {
    nextPeriodic = (present && settings.showEvery) ? now + settings.showEvery * 60000UL : 0;
    if (settings.idleMode == 1 && present && settings.showEvery && waiting && !showPending)
      startShow(now, settings.showSecs);
  }

  if (mode != prevMode && mode == M_SLEEP) sleepSince = now;
  prevMode = mode;

  if (mode != M_REST && mode != M_SERVICE) looking = false;
  if (mode != M_REST) testCh = -1;
  Frame out = live;
  if (mode == M_SERVICE) out = {0, 0, false, live.lid};  // the page's preset, nothing from the sticks
  if (looking) {
    out.sx = lookSx;
    out.sy = lookSy;
  }
  if (testCh >= 0) out = testFrame(now);
  switch (mode) {
    case M_IDLE:
      out = idleFrame(now);
      break;
    case M_PLAY:
      if (!playFrame(now, out)) {
        if (playThenIdle) startShow(now, settings.showSecs);
        else endScene();
        out = mode == M_IDLE ? idleFrame(now) : live;
      }
      break;
    case M_SLEEP:
      out = {0, 0, true, settings.lidClosed};
      // Quiet sleep: once the lids have had time to close, stop the pulses so the
      // cheap servos can't hum or buzz holding position.
      out.limp = settings.sleepQuiet && now - sleepSince > 1000;
      break;
    case M_RECORD:
      recordSample(live, now);
      break;
    default:
      break;
  }

  if (mode != shownMode) {
    Serial.printf("Scene: %s\n", sceneModeName());
    setLightBar(mode);
    shownMode = mode;
  }
  return out;
}

SceneMode sceneMode() { return mode; }

const char *sceneModeName() {
  if (mode == M_REST && testCh >= 0) return "test";
  switch (mode) {
    case M_LIVE: return "live";
    case M_IDLE: return "idle";
    case M_PLAY: return "play";
    case M_RECORD: return "record";
    case M_SLEEP: return "sleep";
    case M_SERVICE: return "service";
    default: return "rest";
  }
}

bool sceneCommand(const String &cmd) {
  uint32_t now = millis();
  // look<L|R|U|D|C>: full to his left / his right / up / down, or center (+ sx = his left, + sy = up)
  if (cmd == "service") {
    if (mode == M_SERVICE) {
      mode = M_REST;
      serviceStore(false);
    } else {
      stopScene();
      mode = M_SERVICE;
      looking = false;
      setLidPreset(0);
      serviceStore(true);
    }
    showPending = false;
    sleepAfterHands = false;
    return true;
  }
  if (cmd.length() == 5 && cmd.startsWith("look") && strchr("LRUDC", cmd[4])) {
    if (mode != M_SERVICE) stopScene();
    showPending = false;
    sleepAfterHands = false;
    char c = cmd[4];
    lookSx = c == 'L' ? 127 : c == 'R' ? -128 : 0;
    lookSy = c == 'U' ? 127 : c == 'D' ? -128 : 0;
    looking = true;
    testCh = -1;
    return true;
  }
  looking = false;
  int n = cmd.length();
  if (cmd.startsWith("test") && (n == 5 || (n == 6 && cmd[5] == 's')) && strchr("012345AH", cmd[4])) {
    if (mode == M_SERVICE) return false;
    stopScene();
    showPending = false;
    sleepAfterHands = false;
    testCh = isdigit(cmd[4]) ? cmd[4] - '0' : cmd[4] == 'A' ? 6 : 7;
    testSudden = n == 6;
    testAt = now;
    return true;
  }
  testCh = -1;
  if (mode == M_SERVICE) return cmd == "stop";  // only the page's own holds; the rest waits
  if (cmd == "idle" || cmd == "show") return startShow(now, settings.showSecs);
  else if (cmd == "extended") return startShow(now, settings.extendMins * 60UL);
  else if (cmd == "play") return startPlay(now, false);
  else if (cmd == "record") return startRecord();
  else if (cmd == "stop") stopScene();  // rest, eyes open, until something else happens
  else if (cmd == "sleep") { stopScene(); mode = M_SLEEP; }
  else if (cmd == "wake") { if (mode == M_SLEEP) mode = M_REST; }
  else return false;
  showPending = false;
  sleepAfterHands = false;
  return true;
}

void scenesBoot() {
  if (serviceSaved()) {
    mode = M_SERVICE;
    setLidPreset(0);
    Serial.println("Scene: service (held from before the restart)");
    return;
  }
  // Power-up counts as an arrival, so the cycle works before the radar reports anything
  if (settings.idleMode == 1) {
    showPending = true;
    showAt = millis() + settings.arriveDelay * 1000UL;
  }
}

void scenePresence(bool on) {
  uint32_t now = millis();
  if (on == present) return;  // Home Assistant may repeat itself
  present = on;
  if (!on) {
    emptySince = now;
    showPending = false;  // left during the wait: no show to an empty room
    nextPeriodic = 0;
    return;
  }
  if (mode == M_SLEEP && settings.idleMode == 0) mode = M_REST;
  nextPeriodic = settings.showEvery ? now + settings.showEvery * 60000UL : 0;
  // A new arrival only after the lab was empty emptyMins: a quick step out doesn't count
  bool arrival = !everPresent || now - emptySince >= settings.emptyMins * 60000UL;
  everPresent = true;
  if (!arrival || settings.idleMode != 1) return;
  if (mode == M_RECORD || mode == M_PLAY || mode == M_IDLE || mode == M_LIVE) return;
  showPending = true;
  showAt = now + settings.arriveDelay * 1000UL;
}

bool scenePresent() { return present; }

String sceneTestLabel() {
  if (testCh < 0) return "";
  static const char *const NAMES[] = {"servo 0, left/right", "servo 1, up/down", "servo 2, his left top lid",
                                      "servo 3, his left bottom lid", "servo 4, his right top lid",
                                      "servo 5, his right bottom lid", "all six moving", "all six holding still"};
  String s = NAMES[testCh];
  if (testCh < 7) s += testSudden ? ", sudden" : ", eased";
  return s + ", " + String((TEST_MS - min<uint32_t>(TEST_MS, millis() - testAt)) / 1000) + " s left";
}

// Seconds to the next show the eyes will start on their own, -1 = none scheduled
int sceneNextShowSecs() {
  if (mode == M_SERVICE) return -1;
  uint32_t now = millis();
  int32_t best = -1;
  if (showPending) best = max<int32_t>(0, (int32_t)(showAt - now));
  if (nextPeriodic && settings.idleMode == 1) {
    int32_t d = max<int32_t>(0, (int32_t)(nextPeriodic - now));
    if (best < 0 || d < best) best = d;
  }
  return best < 0 ? -1 : (int)(best / 1000);
}

// Seconds left in the running show, -1 = no show running
int sceneShowLeftSecs() {
  if (mode != M_IDLE) return -1;
  return max<int32_t>(0, (int32_t)(idleUntil - millis())) / 1000;
}

uint32_t recordingMs() { return storedFrames * FRAME_MS; }
