scottdube/animatronic-eyes/(commit log)

2026-09-24 Basic EyeMech: surviving sketch, kit reference, and the lost controller version
    Imported from iCloud Downloads (2024-05-16 copy): the stock Nilheim
    Low_Tier_Code plus three debug prints. The game-controller edit Scott made
    was searched for across this Mac, Google Drive (mount + full-text), the IDE
    recents, GitHub and both Trashes, and is not here. It most likely lived only
    in the closed Arduino Cloud account. Imported the 2024 copy rather than the
    2019 Drive original because it is the one Scott edited.
    STLs left out: they are 3D-print sources still in Drive, and the repo only
    needs what the firmware work reads.
2026-09-24 EyeMech_PS4: rebuild the lost controller sketch for ESP32 + DS4 clone
    PS4Controller (pablomarquez76) rather than Bluepad32: it is the library
    already installed on this Mac on 2025-05-30, so most likely what the lost
    version used, and it builds on the stock esp32 core with no extra board
    package. Bluepad32 stays the fallback if the clone won't take the MAC.
    Kit servo math kept byte-for-byte; sticks are mapped into the 0..1023 range
    analogRead gave so nothing downstream changed. Compiles clean on esp32 3.3.7;
    not yet flashed.
2026-09-24 EyeMech_PS4: actually print the ESP32 Bluetooth MAC at boot
    The header comment promised it and pairing depends on knowing it.
2026-09-24 backup: full flash dump of the working board before reflashing
    This is the only surviving copy of the lost PS4 sketch, and it is compiled.
    Verified against the chip (verify-flash digest match). It settles the library
    question: PS4-HIDC/PS4-HIDI are in the app. The NVS bond names the
    controller.
    Committed in-repo rather than kept only in scratch because the board is
    about to be overwritten. The dump carries a BT link key, so this repo stays
    private.
2026-09-24 Rebuild verified: DS4 connects on the existing bond, sticks full range
    Serial showed 'PS4 connected' after one P4 press. No re-pairing was needed, which settles
    that the original used the ESP32's own MAC. Not yet checked: blink, trim, axis direction,
    and reconnect.
2026-09-24 Reconnect verified: hold P4 ~10 s to turn the DS4 off, then press P4
    After two quick board resets, P4 alone didn't reconnect. The full off/on did, with no
    power cycle of the eyes. This morning's 'lost control' is now likelier a controller that
    was never really off than a firmware fault. Recorded as a hypothesis, not a cause.
2026-09-24 EyeMech_PS4: Y_PARK 120 -> 180; boot with lid trim at 40 (fully open)
    Scott asked for the eyes lower and the lids fully open at power-up. Trim 40 gives the
    smallest upper-lid pulse and the largest lower-lid pulse, which is the most open by the
    blink positions (upper 400 / lower 240 = closed). This is the same value D-pad up tops out at.
2026-09-24 EyeMech_PS4: Wi-Fi on, with a coexistence stat line, on the OTA partition layout
    Step 1 of OTA/settings. Measured: controller packets 99/s with Wi-Fi vs 111/s without,
    0 disconnects. Coexistence is fine. The only tight resource is heap (~51 KB free). Kept as the
    base for step 2 rather than thrown away. The serial 'w' toggle and stat line stay for
    now as the instrument. Credentials are compile-time in a git-ignored secrets.h, like
    the Orb's fallback. The Orb's setup portal (WiFiManager) was rejected for now: more heap on a
    51 KB budget, for a device that never moves networks.
2026-09-24 EyeMech_PS4: web settings page (live) + OTA upload, and build.sh
    Step 2. Modelled on hot-info-orbs' OtaUpdater/SettingsPage, with two deliberate
    differences. Settings apply live and are saved only on Save, because the Orbs'
    save-and-restart would drop the controller every time. And there's no boot-picture/LittleFS,
    because only ~51 KB of heap is free with Wi-Fi + BT. The upload handler checks auth itself, since
    Update.end(true) switches the boot slot and the final handler runs too late to stop it.
    build.sh writes build_id.h so /update shows which commit is running.
2026-09-24 EyeMech_PS4: report the running OTA slot on /status and the page
    So an OTA can be seen to have switched slots rather than just rebooted into the old one.
2026-09-24 Spec: EyeMech scenes (alive idle, record/replay), lid sliders, radar trigger
    Approved in chat 2026-09-24. The radar goes through HA calling /presence on the eyes. An HA
    token on the eyes (a secret on a passwordless device, and heap) and ESPHome calling the eyes
    (ties the radar firmware to the eyes) were both rejected.
2026-09-24 Scenes: alive idle, record/replay, lid sliders, radar endpoint
    Scenes.cpp owns who drives the eyes (controller > play > idle > rest, sleep =
    lids held closed); every source emits the controller's Frame so the kit's
    servo math stays the one path to the servos. Recording goes raw into the spare
    spiffs partition (no filesystem, no heap) rather than LittleFS, which would cost
    heap we don't have with BT + Wi-Fi up (~44 KB free).
    emptyAction=rest holds rest until presence/takeover: otherwise automatic idle
    would restart immediately (already unattended) and 'rest' would mean nothing.
    Record needs the controller connected: a recording IS the controller driving.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
2026-09-24 Idle: pick glances in eye travel around rest, not stick units
    Scott: pupils never visible while idling, too high. With parkY 270 the rest
    sits at 242 of 1023, so the stick's upper half spans 781 units and the lower
    242: symmetric stick targets went ~3x further up than down. Converting back
    through the inverse of stickToAdc keeps Frame in stick units, so record/play
    and the controller path are unchanged. /status now reports x and y to measure it.
2026-09-24 PCA9685 watchdog: read the prescaler back every second, re-init if lost
    Scott: after re-seating horns nothing moved, no buzz, while the controller
    showed connected and /status answered. A PCA9685 that loses logic power resets
    to sleep with outputs off and the sketch only configured it in setup().
    Prescale read-back rather than MODE1: the library exposes readPrescale()
    publicly; after a chip reset it reads 30 (the power-on default) not ours.
2026-09-24 CLAUDE.md: dead servos after horn work, PCA watchdog, what to check next
2026-09-24 CLAUDE.md: dead servos were a power fault, not the PCA; horn re-seat redone
2026-09-24 lidMin range down to 200
    Scott, at 250 (his original sketch's limit) after re-seating the lid horns:
    keep going. The re-seat moved where closed/open fall on the spline, so 250
    is no longer the mechanism's limit; stepping by eye, listening for a stall.
2026-09-24 CLAUDE.md: servo 1 runaway during idle, facts vs hypotheses
2026-09-24 CLAUDE.md: servos on the ESP32 5 V pin is the likely runaway cause
2026-09-24 Lid presets: wide / normal / squint / closed replace the trim knob
    Scott's design: four lid positions, everything else a combination. Each lid
    servo is interpolated between its own closed pulse (the kit's blink, which the
    horns were seated to; 4 and 5 are not exact mirrors, so not 680-x) and its
    open pulse. Bottom lids use sqrt so they stay mostly open until nearly shut,
    as the kit's trim did (moved them half as far): normal 75% gives top 295,
    the same as the approved trim 5, bottom 418 vs 427. D-pad steps presets
    instead of trim; blink = closed preset; idle sits at normal with the odd
    squint or wide look. Recording magic bumped to EYR2 (byte 3 now lid %).
    bootTrim/trimStep dropped: their NV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
2026-09-24 CLAUDE.md: lid presets tuned live — normal 60, bottoms match tops (curve 100)
    Recorded before Save because the values are live-only; a restart loses them. Curve 50 (kit-like
    gentle bottoms) was rejected: at 60 % the bottoms stayed too open for Scott.
2026-09-24 lidBalance: scale one eye's lid travel to match the other
    Scott measured 10.5 vs 7.5 mm at squint. Scaling from each servo's closed pulse keeps the seal
    the horns were seated to; an additive offset would unseal the closed lids. Equalising all four
    servos' travel was rejected: at wide it drives servo 5 to ~160, beyond the range checked.
2026-09-24 Widen the lid open limits: lidMin to 160, lowLidMax to 520
    Scott wants wide wider; 200/480 were the old slider ends, not a measured mechanical stop.
    Pulses stay inside SG90 range (~0.6-2.4 ms = 150-600 counts at 60 Hz). Stepped live with Scott
    watching for buzz rather than jumping to the new ends.
2026-09-24 CLAUDE.md: servos 4+5 are the viewer's-right eye (from photo); balance 0 live
2026-09-24 CLAUDE.md: correct the eye mapping — servos 4+5 are the viewer's LEFT eye
    Measured by toggling lidBalance with Scott watching; the earlier photo-based reading was wrong
    because horn moves between shots made the photo compare two uncontrolled eyes.
2026-09-24 CLAUDE.md: horns alone cannot fit both lid ends; per-servo trims proposed
2026-09-24 Per-lid closed + open trims replace lidBalance
    A horn is one adjustment in ~17° spline steps, but each lid has two ends to fit, so Scott
    fixing closed moved wide and back again. lidBalance (one scale per eye) was rejected: it
    can't move the closed end and ran out of range at +40. Trims are in lid terms (+ = more
    open) so the page reads the same for servos that turn opposite ways; pulses clamp to
    150-600.
2026-09-24 Web page: preset buttons (Wide/Normal/Squint/Closed)
    Scott had no way to reach a preset from the page without nudging its slider, and the
    D-pad needs the controller, which every OTA drops. Buttons re-send the preset's current
    value through /set, which already switches the eyes to it — no new endpoint.
2026-09-24 CLAUDE.md: preset buttons, botLClosed -14 saved
2026-09-25 Scenes: Stop holds, and a timed idle run really ends
    Both let auto idle straight back in: a page Stop lasted autoIdleSecs, and a timed run
    (Triangle/page/arrival, idleRunMins) ended into rest already 'unattended', so idle restarted
    on the next loop. Now both set holdRest, cleared by the controller (edges only — a held
    Triangle cleared the hold its own press set), an arrival, or a page command. Rejected making
    Stop set idleMode 0: that's a saved setting, and a Save would store idle off.
    /status gains 'held'; the page shows it. US spelling in the firmware (Scott).
2026-09-25 CLAUDE.md: 00b4e90 built but not deployed — eyes unreachable
2026-09-25 CLAUDE.md: automatic idle runs 24/7 without the radar; Scott powered the eyes off
2026-09-25 CLAUDE.md: Scott's usage requirement — short show on arrival, then sleep; extended play on demand
2026-09-25 Show cycle: arrival show, then sleep; periodic and extended on demand
    Scott's use: walk in, 30 s later a 2-3 min show, then sleep while he's in the lab (the servos
    are loud); another show on a return after the lab was empty, and every hour while he's there;
    extended play by voice. Automatic idle ran 24/7 and got the eyes powered off, so it's gone,
    and with it holdRest: nothing automatic runs unprompted any more. Sleep now lets the servos go
    (full-off) once the lids close so they can't hum; that's a setting because the lids may sag.
    Periodic shows need the radar: without presence there's no 'while you're here'. US spelling.
2026-09-25 CLAUDE.md: advised against servos on the ESP32 5 V pin; single 5 V/3 A adapter suggested
2026-09-25 CLAUDE.md: show cycle verified live — HA presence reaches the eyes, show ends into sleep
    Recorded from /status, not inferred from the automation config: present flipped
    true after the HA restart and the show ran out into sleep on time.
2026-09-25 web: Save/Revert/Defaults show press and result on the button
    Scott: Save gave no feedback and didn't even look pressed. The only sign was the
    status line flipping to ✓ Saved on the next poll, far above the button, and a
    failed save was swallowed silently. Now the button dims while working, then
    reads ✓ Saved or ⚠ Failed for 2 s. Rejected a toast/alert: the answer belongs
    where the finger is.
2026-09-25 Show: wake look, slow squint, winks; left/right is HIS left/right
    Scott, 2026-09-25:
    - Labels from the animatron's perspective, like up/down, so they survive
    mounting him in a robot. Trims renamed cTopL.. -> cLTop.. (L = his left =
    servos 2+3); saved trims migrate once to the new keys and the old keys are
    removed. Rejected swapping the meaning under the old key names: an old key
    read by old or new code would silently mean the opposite eye. Pupil center
    slider flipped (rtl) so its left end is his left; + stays his left in NVS,
    measured 2026-09-25, so the saved -75 is untouched.
    - A show that starts from sleep opens wide and looks far to his left for 2.5 s.
    - About once a minute: w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
2026-09-25 build.sh: refuse an OTA while the eyes have unsaved changes
    I flashed e9d4a7e without checking /values first. A flash restarts the board
    and drops anything unsaved, and Scott was trimming at the time. Rejected a
    reminder in docs only: the check costs one curl and can't be forgotten.
2026-09-25 Center calibration (xCenter) + look-test buttons; fix trim sliders not selecting their preset
    Scott: the pupil center read -75 with the eyes dead center; it should read 0
    and trim from there. The -75 was the left/right horn's spline offset, a
    calibration, so it moves into xCenter (pulse counts, applied at the servo) and
    parkX becomes 0. Migrated once from NVS: -75 * 220/1023 = -16. Rejected
    re-seating the horn: 75 units is ~6 deg, under one ~17 deg spline tooth.
    Rejected keeping the offset in stick space: it left travel lopsided (+126 /
    -94 pulses about center); at the servo it is +/-110.
    Look test (Scott): page buttons hold full his-left / his-right / up / down /
    center while resting, to c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
2026-09-25 Up/down servo center calibration (yCenter)
    Scott asked for a center for up/down like left/right (he set xCenter -33 by
    eye after 944c6e6). Applied to servo 1's pulse only: the lids follow the
    commanded gaze (yval), so the lid trims he tuned stay valid. Rejected shifting
    yval instead: that would move the lids with it and void every trim.
2026-09-25 Up travel limit (upMax) for the up/down servo
    Scott: full look up strains a little; left, right and down don't. upMax sets
    servo 1's pulse at full up (kit 500) and scales only the upper half, so the
    stick has no dead zone at the top. Rejected a plain clamp: it would leave the
    last part of the stick doing nothing. Down is left alone: it doesn't strain.
2026-09-25 Page: all calibration in one section
    Scott: shouldn't all the calibration be together? Moved top/bottom lid max open
    and the per-preset lid trims (with their own preset buttons, same handler) under
    Calibration with the servo centers, up limit and look test. Everyday section
    keeps pupil center, lid presets, bottom-lid curve and lid follow. Pupil center
    hints now say 0 = true center.
2026-09-25 CLAUDE.md: upMax added, 490 not yet judged; calibration layout
2026-09-25 Service mode; eye roll and edge circle join the show's set pieces
    Service (Scott, for pulling the lid servo to reach the up/down servo): lids to
    the closed preset (the horn reference), eyes centered, servos powered and
    holding; no shows (arrival, periodic, page, voice), no controller, no sleep.
    Sleep is excluded because quiet sleep goes limp and a limp servo turns by
    hand. Page presets and the look test still work, to check the refit. The
    flag is in NVS (namespace scene) so a power cycle mid-job comes back in
    service rather than into the power-up show 30 s later. Rejected telling Scott
    to set Shows off by hand: forgetting to turn it back on is the likely failure.
    Set pieces now rotate every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
2026-09-25 5 V rail monitor + last restart reason in /status and on the page
    Scott wants to settle servo power (USB 5 V pin vs a direct V+ feed) by
    measurement. A PPK2 caps at 1 A, measures current not voltage, and puts a
    shunt in series with the thing under test, so it is kept for a per-servo
    profile. The rail's own sag is what matters: a 10k/10k divider to GPIO34
    (ADC1: works with Wi-Fi) sampled by a core-0 task in bursts of 16 per tick
    (~16k/s) reports now/min/max and dips under 4.6 V. esp_reset_reason() makes a
    brownout visible instead of inferred. Rejected sampling in loop(): ~112/s
    misses millisecond servo dips.
2026-09-25 CLAUDE.md: rail monitor deployed, divider not wired; spike figure is an estimate
2026-09-25 Rail monitor: 1 ms averages against a running level, not single samples vs 4.6 V
    Baseline with the divider wired: single samples spread 3.9-4.77 V on a flat
    4.47 V rail even with the servos asleep, so a single-sample min is ADC noise.
    The USB-fed 5 V pin sits ~4.47 V behind the board's diode, so an absolute
    4.6 V threshold counted a dip forever. Rejected a fixed lower threshold: a
    direct 5 V feed would sit ~0.5 V higher and need another number. A dip is now
    0.4 V below the ~2 s running level; 1 ms averages reach -0.27 V at no load.
2026-09-25 docs: eyeball STL decoded into a native Fusion solid, plus three Fusion MCP traps
    The faceted Convert Mesh body is a solid Fusion can barely work with, and
    Prismatic conversion needs the Design extension. Rejected buying that or
    re-meshing: the shape is a sphere, a bore, a dish and three snap recesses,
    all measurable off the mesh, so a native revolve reproduces it to 0.01 mm.
2026-09-25 CLAUDE.md: rail baseline was servos on the bench PSU (Scott confirmed)
2026-09-25 CLAUDE.md: first USB-only rail run - no visible show, a brownout and a power-on reset
2026-09-25 CLAUDE.md: USB-only show measured - 95 sags, 3.61 V min, no reset
2026-09-25 CLAUDE.md: first scope capture at rest - rails flat, µs needles only
2026-09-25 CLAUDE.md: show capture shows only needles while the ADC logs 3.37 V - conflict open
2026-09-25 CLAUDE.md: Peak Detect shows a continuous ±0.45 V HF band on both rails
2026-09-25 CLAUDE.md: probe band survives tip-on-ground - pickup, not rail ripple
2026-09-25 CLAUDE.md: on laptop USB the band is gone and no wide dip reaches 4.1 V
2026-09-25 CLAUDE.md: runaway on the second laptop-USB show; power pulled
2026-09-25 CLAUDE.md: runaway followed repeated 4.5 V triggers; now on a 2 A wall wart, service on for horn refit
2026-09-25 CLAUDE.md: wall wart show - WAIT at 4.5 V is not a pass, rail sits at 4.5
2026-09-25 Scope: USB-fed servo rail steps 1 V down for >12 ms; 3V3 to ~2.95 V
    Five captures on a 2 A wall wart with a negative-pulse trigger at 4.5 V. Slow
    recoveries from ~4.2 V and one 4.65 -> 3.65 V step held >12 ms, 3V3 following
    it into regulator dropout. Rejected Scott's USB-only feed for the servos on
    this evidence; the bench PSU on V+ showed no sag. The two scope photos that
    carry the finding are committed under docs/scope/.
2026-09-25 CLAUDE.md: board already has 1000 uF; a 12 ms sag is a supply problem, not a cap problem
    Rejected adding bulk capacitance: 1.5 A for 12 ms from 1000 uF is ~18 V of droop,
    so the existing cap is already swamped and a bigger one would only nibble at it.
2026-09-25 CLAUDE.md: plan - LM2596 feeds V+ and the ESP 5 V pin, star-wired
2026-09-25 CLAUDE.md: board shrink - classic BT rules out S3/C3/C6; D1 Mini ESP32 in stock
2026-09-25 Snapshot eye settings before the D1 Mini swap; record the board decision
    The new board boots with defaults and a new MAC, so trims, calibration and the
    fixed IP would all be lost silently. Kept the PCA9685 (Scott) over driving
    servos from LEDC: simpler, and the D1 Mini alone frees enough room.
2026-09-25 CLAUDE.md: controller migration plan - clone the host MAC and copy NVS
    Rejected re-pairing from scratch as the first try: the clone may not accept a
    new host MAC, while presenting the old MAC plus its link key looks to the
    controller like the board it already knows.
2026-09-25 CLAUDE.md: buck input — 12 V 3 A adapter and barrel pigtail already in stock
    Buying the linked Amazon adapter was not needed: stock search found a 12 V 3 A
    adapter and 12 female 5.5x2.1 pigtails. Flagged the adapter's placement next to
    the ZVS pump rather than assuming it is free.
2026-09-25 CLAUDE.md: the Amazon adapter is 12 V 2 A, not 3 A
    The 3 A came from the search keywords in the URL, not the listing. Kept the
    verdict: 24 W still covers the ~12 W the buck needs.
2026-09-25 Carrier PCB: DXF outline in repo; inventory conflicts (D1 Minis and 12 V adapter are claimed)
    Recorded the outline geometry and the two allocation conflicts before designing anything,
    so the board is not planned on parts that another build already owns. Rejected creating a
    new inventory project: part #837 / BO-0010 already exists for the eyes.
2026-09-25 Adopt the DevKit's base MAC at boot so the D1 Mini is the old host on Wi-Fi and BT
    Sets the base MAC at the top of setup(), before any radio init. PS4Controller's own
    begin(mac) does the same write but runs after wifiStart(), so used that way only
    Bluetooth would take the DevKit's identity and the DHCP reservation would have to move.
    Compiled (86% of a slot), NOT flashed: two live boards on one MAC fight, so this goes on
    the D1 Mini only after the DevKit is unpowered.
2026-09-26 carrier: V1 KiCad project, generated — DRC/ERC clean, mill export verified
    One milled single-sided board carrying the D1 Mini ESP32, PCA9685 and
    LM2596 on M3 standoffs into the rack. Outline from Scott's DXF.
    Why generated (gen/*.py) rather than drawn in KiCad: every coordinate is
    in one reviewable file, the board rebuilds from the DXF, and the routing
    argument (which pins are reachable single-sided) lives next to the numbers
    that came out of it. Opening it in the GUI is fine; editing there makes the
    generator stale.
    Why the PCA9685 footprint is Adafruit's rev C Eagle geometry and not
    calipers: the Eagle file is exact for the Adafruit layout the clones copy;
    calipers are still required o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
2026-09-26 CLAUDE.md: carrier V1 placement rejected — servo wires enter at the back; Scott lays out in the GUI, .kicad_pcb is master now
    Recorded before opening KiCad because the project dir is off-limits to
    writes while KiCad holds it. gen_pcb.py is demoted rather than deleted:
    its helpers and routing notes are still the record of why the pins moved.
2026-09-26 CLAUDE.md: carrier drops the rail-monitor divider (Scott) — ADC saw noise, not sag; gen_sch cleanup pending KiCad close
2026-09-26 carrier V2: Scott's placement captured, outline restored, divider dropped, DRC 0
    PCA on H3/H4 (its holes match the carrier's), D1 Mini in the left wing
    with USB-C off the left edge, buck in the right wing, servo headers on
    the bottom edge. No routing yet; V1's tracks belonged to the rejected
    placement and are gone.
    Why a capture step (gen/capture_placement.py -> placement.py) instead of
    making the .kicad_pcb the master: the GUI-only path broke the outline
    within one session (loose Edge.Cuts lines move under box-select) and
    placed three parts off the real board. Regenerating keeps the DXF
    outline, hole keepouts and D1 keepouts correct by construction.
    Why the hole footprint lost its courtya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
2026-09-26 carrier: 12 V terminal to the right edge mid-depth (Scott) for a panel-mount barrel jack
    Wire-entry face toward the edge; the pin labels and ref moved inside the
    KF301 body because outside it they were past the board edge. Alternative
    rejected: a PCB-mount jack — the one Scott has is panel mount with solder
    lugs, so the board only needs a terminal for two wires.
2026-09-26 carrier V2: routed single-sided, DRC 0/0/0, mill export + pcbmill drill check passed
    All copper is in TRACKS in gen/gen_pcb.py (docstring there is the map). Pin decision:
    SDA = IO27 (pad 24), SCL = IO25 (pad 26); firmware needs Wire.begin(27, 25) for the
    carrier build (not changed here). IO21/22 are inner-row pins in Scott's placement and
    the inner row's only exits are the module's USB end (already carrying +5V and +3V3)
    and the antenna end - rejected.
    Rejected alternatives, each of which DRC would have accepted:
    - I2C to the PCA right row across the front bar: crosses the +3V3 lane.
    - +3V3 down the far-left edge: fills the 1.35 mm strip that is GND's only path
    into the D1's middle (pad 3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
2026-09-26 carrier: attach 3D models to every footprint (ratgdo D1/LM2596, GrabCAD PCA9685, stock for the rest)
    Models are emitted by gen/footprints.py so the generator stays the single
    master; hand-adding them in the footprint editor would be overwritten on the
    next regenerate. 3dmodels/ (34 MB) is committed rather than referenced from
    the ratgdo checkout or Downloads: the board must rebuild from this repo
    alone, and the ratgdo files exist nowhere else.
    PCA9685: rotate (-90,0,180) offset (-0.18,-0.36,2.54). The offset derived
    from the STEP's raw points was wrong by 29 mm and a quarter turn (assembly
    placement not applied) - transform found by rendering candidates on scratch
    boards, verified by top-or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
2026-09-26 carrier: J1 turned to face the back of the box, D1 model without sockets
    Scott's review of the 3D view: the terminal block's wire entry faced the
    board edge it sat against, and the D1 Mini sat on female sockets it will
    not have. J1 moves below the buck at (50.5,14.5) rot 180 so the entry faces
    the PCA edge (the back of the box) and the wires leave over the chamfer;
    TP5 moves to (54,7.5) out from under it. Rejected: keeping J1 on the right
    edge turned 180 - its body then overlaps the LM2596 courtyard unless pushed
    to 0.2 mm from the edge. +12V rerouted J1.1 -> north -> TP1 with the y=2
    run teeing off; J1 GND made solid (full return current, same as IN-).
    D1: ratgdo's STEP with the socket SHAP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
2026-09-26 carrier: J1 at Scott's spot, C1 turned, schematic parity clean, STEP re-exported
    Scott placed J1 at (45.05,15.7) between H4 and the chamfer after my move
    left its body against the buck's IN- corner, and turned C1 so the TP2 stub
    runs straight into it; that removes the diagonal and the pour sliver
    (pour is one polygon). +12V goes east under J1 then north: straight north
    from the new pad would graze IN- by 0.05.
    The parity errors he saw were generator defects: NC pads without the
    netlist's unconnected-() nets, symbol Description empty, Datasheet ~ vs
    empty, and two different J1 values. Fixed at the source (gen_pcb/gen_sch)
    rather than by excluding them in the .kicad_pro, so the check stays liv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
2026-09-26 carrier: laser fit-check SVG for xTool (red cut = outline + holes, black engrave = silk)
    Scott lasers a 1.5 mm basswood copy with holes before committing to the
    mill. make_fitcheck.py post-processes kicad-cli's Edge.Cuts+F.SilkS SVG:
    outline chained into one closed path, drill marks turned from filled
    discs into stroked circles at drill diameter, silk recoloured black,
    opacity-0 helper <text> removed, 1 mm viewBox margin added.
    Rejected shipping kicad-cli's SVG as-is: filled drill discs would be
    engraved solid, grey/yellow layer colours give nothing to select on in
    XCS, and the viewBox clips the right and bottom edge lines. Rejected
    writing the script beside export_for_mill.sh: that is the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
2026-09-26 carrier: back chamfers corner-to-corner (DXF kink was a cleanup error), silk text enlarged
    The wood fit check against the case showed one straight chamfer where the
    DXF had two segments; Scott confirmed the DXF was hand-edited after the
    Fusion export. The two kink vertices are dropped from OUTLINE; outline.dxf
    is no longer the master. Rejected re-exporting from Fusion: the case model
    is not in this repo and the endpoints on the back edge and side matched the
    case, so only the middle line was wrong.
    Silk: refdes 1.0->1.2, labels 0.8->1.0, legend 0.9->1.2; LM2596 IN/OUT
    labels moved 1.3 mm inward to clear the module outline. DRC+parity 0,
    ERC 0, gerbers/drill/fit-check/STEP regenerated.
    Co-A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
2026-09-26 carrier: back chamfers 4 mm deeper; two traces rerouted, no placement moved
    Corner-to-corner still stuck out past the case panel at both back corners in
    the wood check. Scott's estimate (not measured): bring each back corner in
    about 4 mm. The chamfer is the corner-to-corner line offset 4 mm inward,
    parallel: back-edge end -40.598 -> -35.420, side end 18.361 -> 12.061,
    mirrored. Two caliper readings per corner would replace the estimate.
    The new edge cut through two traces, so those moved and nothing else did:
    - +5V trunk corner (-37.9, 34.5) is outside the deeper chamfer; it turns
    north at -33.8 now, then (-33.8, 18.2) -> TP2.
    - +12V vertical 50.5 -> 47.5: the chamfer meeting the x=50.5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
2026-09-26 carrier: 4 mm chamfer FITS the case (wood check 2); outline frozen for V2
2026-09-26 carrier: pcbmill job opened, gate passed; blocker = no blank stock big enough (only 4x2.7 in on hand)
2026-09-26 carrier: BLOCKER retracted — 150x100x0.8 mm blank IS in stock (my tail -40 hid it); job set to that blank, depths cut for 0.8 mm
2026-09-26 CLAUDE.md: carrier probe program deployed to ~/gcode on the laptop (Scott's call), not the Tormach share
    The share exists (tormachpcnc 192.168.1.100, Samba share 'gcode', guest)
    but mounts at /Volumes/gcode, the job default expects /Volumes/Tormach/gcode,
    /Volumes is not writable, and every mount attempt raised a Finder dialog.
    Scott said to use the laptop gcode dir instead, so machine.gcode_dir now
    points there. Next step is his: run the probe at the console.
2026-09-26 CLAUDE.md: carrier Z0 is the copper with 0 typed in; blank calipered 0.80 mm; probe program regenerated + redeployed
    Supersedes the typed-thickness workaround from an hour earlier: pcbmill
    itself now audits from the board bottom, so the console procedure is the
    plain electrical touch.
2026-09-26 CLAUDE.md: carrier console has two zeros - probe zero frames the map, V-bit electrical touch at the highest node is the zero the cuts use
2026-09-26 Carrier: G54 X0 Y0 set by eye with the V-bit at the blank's lower-left corner; fix the stale 'Z0 on the MDF' line
    The by-eye origin is accepted rather than picked up with an edge finder: no
    board feature references the blank edge and the CAM offsets already leave
    margin, so edge-finding would buy precision nothing consumes.
2026-09-26 Carrier: record the board's inset from the by-eye X0 Y0 (0.63 in sides, 0.55 in top/bottom)
2026-09-26 Carrier: probe program is on /Volumes/Tormach/gcode after all; the laptop-gcode detour was mine
    The share I was probing on the controller (192.168.1.100) is not the one
    PathPilot reads; the real one is the NAS share already mounted at
    /Volumes/Tormach. Kept the wrong-turn paragraph rather than deleting it so
    the next session sees why the default was never the problem.
2026-09-26 Carrier: probe map imported and red-flagged — 21 thou dome, 2× any deskv1 map; seat suspect, not voids
2026-09-26 Carrier: cleared to cut — dome accepted by Scott, isolation widened 0.03→0.04 to kill the header-row slivers, JOB READY, three cut files on the share
    Widening isolation was chosen over oval pads in KiCad because the blank is
    already mounted and probed; the pad change belongs to v3.
2026-09-26 Carrier: touch-off validated at two nodes within 0.7 thou; isolation cut cleared
2026-09-27 Carrier: isolation cut done
2026-09-27 Carrier: drilling done
2026-09-27 Carrier: outline on T615 fishtail, ramped 3-pass; keepouts 6/2/5 cleared on T610
    Ramped file is hand-built from the pcb2gcode path because pcb2gcode can
    only plunge at full depth. The pour-exclusion keepouts around the standoff
    holes (1,3,4,7) are deliberately left: their island is the hole annulus.
2026-09-27 Carrier: legend SVG for the real board (make_fitcheck.py --board) — outline+holes blue align-only, silk black
    Rejected handing over gerbers/silkscreen.svg: KiCad's colours (pale yellow silk) and no
    alignment geometry, so there is nothing to register the legend to the milled holes with.
    Rejected a second script: fit check and legend must come from one drawing.
2026-09-27 Carrier: legend as a 1200 dpi raster (make_legend_png.py) for F1 profile B
    Rejected lasering the SVG: KiCad stroke text imports into XCS as hollow doubled letters
    (fabrication guide section 7), and profile B is a bitmap recipe. SVG kept as camera guide.
2026-09-27 Carrier: legend on bare FR-4 at 85%/300 mm/s x4 - painting dropped
2026-09-27 Carrier: bare FR-4 legend was the FIBER laser, not blue
2026-09-27 Carrier: legend lasered - fiber 85%/300/30 kHz x4, run twice on the board
2026-09-28 CLAUDE.md: assembly BOM check — InvenTree BOM still carries the dropped rail divider
    Left the InvenTree line in place for Scott to confirm instead of deleting it:
    the BOM is his record and removing it silently hides that the design changed.
2026-09-28 CLAUDE.md: divider line removed from the eyes BOM in InvenTree
2026-09-28 CLAUDE.md: carrier stuffed 2026-09-28, not yet powered; buck setting unrecorded
    Recorded before bring-up so the unknown buck setpoint is on disk, not only in chat.
2026-09-28 firmware: I2C on IO27/IO25 for the carrier (Wire.begin before pwm.begin)
    The carrier routes SDA/SCL to pads 24/26; 21/22 are inner-row pins with no route out.
    Wire.begin goes in setup() once, not inside pcaSetup(): pcaCheck() re-runs pcaSetup()
    on a live bus. Adafruit's begin() then calls Wire.begin() with no pins, which core 3.x
    treats as already started and keeps 27/25. Not made switchable per board: the DevKit is
    retired. Compiled, not flashed.
2026-09-28 CLAUDE.md: carrier first power, 3V3 at 2.7 V, cause open
2026-09-28 CLAUDE.md: TP2 5.08 V, so the 2.7 V 3V3 is a load or regulator fault, not supply
2026-09-28 CLAUDE.md: +3V3 not shorted (2 MΩ off); next: 5V/3V3 at the module's own pins, boot log
2026-09-28 CLAUDE.md: thermal shows no overload on the D1; 2.7 V cause still open
2026-09-28 CLAUDE.md: 2.7 V persists on our firmware; next split module pin vs TP3
2026-09-28 Carrier 3V3 is 3.3 V at the pins; the bad readings were a mirrored probe reference
    -1.9 V = 3.3 - 5.2: the black lead was on +5V when probing from the copper side.
    TRAPS entry added. Kept as hypothesis until re-probed underneath against TP5.
2026-09-28 Copper-side readings: Scott's lead was on 'ground'; open question is whether that copper is GND
    TRAPS entry reworded from a stated cause to a hypothesis.
2026-09-28 CLAUDE.md: regulator reads 5 in / 2.7 out on carrier power only; next split regulator vs D1 ground
2026-09-28 Carrier: likely cause of the 2.7 V 3V3 - a D1 GND pin never soldered (thermal-relief pad)
    Pending Scott's re-measure after soldering it.
2026-09-28 TRAPS: mark the unsoldered-GND entry pending until re-measured
2026-09-28 Carrier: 3V3 = 3.3 V after soldering the missed D1 GND pin - cause confirmed
2026-09-28 CLAUDE.md: 09-25 settings restored onto the D1 and read back
    Scott chose the snapshot over reading the DevKit's current NVS first.
2026-09-28 CLAUDE.md: post-fix thermal, D1 regulator corner 107.6 F - normal
2026-09-28 CLAUDE.md: controller connects to the D1 on the adopted MAC alone - board swap complete
    Rejected copying the DevKit's NVS for the link key: not needed, the MAC alone was enough.
2026-09-28 CLAUDE.md: controller reconnect after servo move - status showed conn true, then false
2026-09-28 firmware: controller battery + charging in /status, on the page, and in the disconnect log
    Kept the last level after a disconnect: the point is to read a drop against the level the
    controller last reported (Scott suspects a dying battery). Shown raw on the DS4's 0-10 scale
    (11 = full while charging) rather than as a percent: the clone's scale isn't verified.
2026-09-28 CLAUDE.md: battery readout flashed; the OTA restart dropped Scott's controller mid-test
2026-09-28 CLAUDE.md: controller input reaches the board, eyes don't move; pcaResets 1
2026-09-28 CLAUDE.md: no servo motion; leading hypothesis PCA GND not reaching the carrier
2026-09-28 CLAUDE.md: PCA ground fine (5 V at the servo header); next signal pin and OE
2026-09-28 CLAUDE.md: first scope look at servo signal - wrong timebase, inconclusive
2026-09-28 CLAUDE.md: scope confirms no pulses on the servo signal pin
2026-09-28 CLAUDE.md: rest-mode scope shows no edges crossing 0.6-2 V; trace position off-screen
2026-09-28 CLAUDE.md: ch-0 signal pin sits at 0 V in rest; fault is chip-wide output, not bus
2026-09-28 firmware: GET /pca dumps MODE1/MODE2/prescale/ALL_LED/ch0-5 registers
    Carrier bring-up: I2C answers and prescale reads 101, yet ch-0 sits at 0 V in rest.
    The prescale check can't see a stopped oscillator or a full-off bit; reading the
    registers settles it without guessing. Rejected adding them to /status: polled
    every 2 s by the page, and 30 extra I2C reads per poll on the loop task.
2026-09-28 CLAUDE.md: PWM pin driven low; OE floating high is the leading hypothesis
2026-09-28 firmware: POST /pcatest holds ch 0-5 full-on/off, bypassing the PWM counter
    Registers read right and OE is grounded, yet the pins sit at 0 V. Full-on
    is a DC level independent of the oscillator and counter: 3.3 V means the
    output stage works and the counter doesn't; 0 V means the output path is dead.
2026-09-28 CLAUDE.md: carrier PCA9685 outputs dead (full-on reads 0 V); replace module
2026-09-28 CLAUDE.md: replacement PCA on the carrier pulses; D1 + carrier verified to the servo pins
2026-09-28 firmware: pcaCheck compares the prescale against 101, not the boot read
    The dead carrier module read 254 at boot and every second after, matched itself,
    and reported pca true with every output at 0 V. Comparing against the value
    setPWMFreq(60) must produce catches that at power-up (pca false, pcaResets
    climbing). Rejected also checking MODE1: the dead chip's MODE1 was never read,
    so there is no evidence it would have differed.
2026-09-28 CLAUDE.md: battery readout verified on the page
2026-09-28 web page: boxed sections, jump bar, sticky Save bar
    Scott: the page was one long block and hard to find things in. Every section
    is now a card (Now, Eyes & lids, Shows, Alive idle, Controller, Radar), two
    columns on a wide screen, with a jump bar at the top. Calibration is its own
    dashed box marked 'set once'. Saved/unsaved moved from the status line to a
    sticky bar with Save/Revert/Defaults, so it is always in view. The long show
    explanation folds away. Rail line says only the last restart: the carrier
    has no divider. Rejected collapsing sections: all info all the time, and the
    jump bar finds them. Every control id and all page JS behavior unchanged
    (checked by script); previewed read-only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
2026-09-28 PCA forensics: pinout verified vs datasheet; unpowered ohms before the 0x41 rig
    The 0x41 parallel rig needs an A0 bridge, firmware and a USB flash that drops
    the controller. A meter unpowered answers chip-vs-path directly: ~220 ohm from
    each LED leg to its header pin means the path is whole. Rig kept as fallback.
2026-09-28 PCA forensics: all six output paths read ~220 ohm leg-to-header; joint/array ruled out
2026-09-28 PCA forensics: bad joint on chip pin 14 (VSS) found; dead-output cause now a hypothesis pending reflow
    Salvage is on hold: a module with an open ground may be fully repairable.
2026-09-28 PCA forensics: pin 28 VDD reads 0 ohm; pin 14 is the only open path
2026-09-28 firmware: /pca and /pcatest take addr= for a second module on the bus
    To run the reflowed dead module at 0x41 alongside the carrier's 0x40 chip.
    Raw register writes, not a second Adafruit driver: its begin() re-runs
    Wire.begin() and could pull the bus back to the default pins 21/22, and the
    0x40 driver + watchdog must stay untouched while the eyes run. Off 0x40,
    out=run means 1.5 ms pulses, since there is no loop driving that chip.
2026-09-28 pca_bench_test: serial-only sketch to prove the reflowed module on a spare DevKit
    Rejected the 0x41 rig on the carrier: it needs an A0 bridge, a USB flash of the
    eyes and drops the controller. Rejected the eyes firmware on the spare board: it
    copies the old DevKit's base MAC, so it would collide with the D1 on .211 and BT.
2026-09-28 pca_bench_test: q probe (error code + time); both addresses time out, SCL low at the ESP
2026-10-13 CLAUDE.md: flag the 09-24 runaway section as superseded on power
    Scott, 2026-10-13: servos are fed by a buck converter straight to PCA9685 V+.
    The OPEN section still read as if they ran off the ESP32 5 V pin, and a session
    quoted it as current. Banner rather than rewriting the section: the history of
    how the USB feed was ruled out is still the evidence for the buck.
2026-10-13 firmware: drift on/off and timed glances (glanceMs) to cut gear noise
    Scott, 2026-10-13: the noise is the SG90 gear train. Idle never let it rest:
    a drift nudge every 0.3-0.7 s, and every glance an exponential that starts
    at full speed. glanceMs > 0 replaces it with a minimum-jerk move (zero speed
    and acceleration at both ends); drift 0 holds still between glances. Both
    default to the original behavior so the flash changes nothing until a slider
    moves. Drift waits for a timed glance to finish, or each nudge would restart
    it from rest mid-move. Rejected swapping servos first: digital servos whine
    louder at hold, and a PCB motor has ~100x too little torque.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
2026-10-13 hardware: add Will Cogley Basic EyeMech kit STLs
    The 16 printable parts plus Reference/Complete Model.stl and the kit
    License.html (CC BY-NC-SA 4.0), copied from Google Drive
    My Drive/#3D prints/basic_eyemech_download_package/Basic Eyemech/.
    Those Drive files are online-only (0 B on disk until opened), so the
    repo copy is the first one that is always local.
    Kept the kit's own filenames, (x2) counts included, rather than
    renaming: they match Cogley's docs and the Drive original. Repo stays
    private, so the NC-SA terms are not a concern for this push.
2026-10-13 hardware: script to convert the kit STLs into Fusion designs
    All 16 printable STLs measured closed and manifold, mm units, 640 to
    23k triangles, so each converts to one faceted solid. Complete Model
    is skipped: 126 non-manifold edges where the assembled parts touch,
    and it is a reference, not a part.
    Faceted rather than Prismatic because Prismatic needs the Design
    Extension this licence lacks (docs/eyeball-cad.md). Written as a
    script Fusion runs itself because the Fusion MCP connector failed to
    start for Code sessions on 2026-10-13 (version negotiation error in
    the desktop app log); the same file runs through the MCP once it is
    back. A copy is installed in Fusion's API/Scripts folder.
    Co-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
2026-10-13 CLAUDE.md: kit STLs, the f3d conversion script, and the MCP traps hit running it
    Recorded that the conversion is not yet run and why it is handed to
    Fusion's own Scripts dialog: the MCP connector dropped after a timeout
    and stayed unavailable across a Fusion restart.
2026-10-13 hardware: the 15 kit parts as Fusion designs (.f3d), plus run notes
    Converted by EyeMechKitToF3D.py through the Fusion MCP: mesh insert,
    Convert Mesh Faceted, export .f3d, save to the hub (Animatronic Eyes /
    Basic EyeMech kit). Every solid's volume matches its STL within 0.012%.
    Faceted, not Prismatic: Prismatic needs the Design Extension. A native
    rebuild per part (as docs/eyeball-cad.md did for the eyeball) is the
    route to editable features and was not attempted here.
    Kept the .f3d files in git despite 27 MB: the hub copies are not
    versioned with the repo, and none is near GitHub's 100 MB file limit.
    Corrects the earlier '16 printable' count to 15; the 16th STL is the
    reference assembly.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
2026-10-13 docs: Eye Adaptor decoded so far, and the mesh-decoding tools
    Saved mid-task because Scott is closing the laptop. Holes, lugs,
    gussets, centre lug and ramp are measured (most as exact vertex
    fits); the snap fingers and the -X rib feature are not yet decoded,
    and nothing is built in Fusion.
    Circle fits use mesh vertices, not ray-cast samples: a tessellated
    arc's vertices sit on the true circle while samples between them do
    not, which is what made the side-lug top look asymmetric at first.
2026-10-14 Eye Adaptor: native Fusion rebuild, within 0.0009 mm of every STL vertex
    hardware/native/eye_adaptor_native.py builds "Eye Adaptor native" (hub: Basic
    EyeMech kit; .f3d alongside) from the decode in docs/eye-adaptor-cad.md, as a
    timeline of sketches, extrudes, revolves and combines.
    Measured: all 3,969 vertices within 0.0009 mm. Volume is 1.5498 vs the faceted
    1.5492 cm3, larger as expected from convex facets.
    Added tools/meshcad/thickdiff.py because the vertex check alone passed at
    0.04 mm while the volume was 3.7 mm3 short. It is a column-thickness
    comparison, and it found two errors that left no vertex off the body:
    - the lug holes cut 0.1 mm into the gusset;
    - a flat on the gusset top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
2026-10-14 Native solids for the four plate linkages (lid links, Y-Arm, Three-Point Connector)
    plate.py shows each is a pure plate (every triangle a cap or a wall), so each is
    rebuilt as one profile extruded through its thickness. profile2d.py decodes the
    cap boundary into lines and arcs (fit residual <= 0.0001 mm), and plates_native.py
    builds them in the STL frame so they drop into the kit assembly unchanged.
    Checks: every STL vertex is within 0.0002 mm of the native body, volumes agree to
    0.0001 cm3, and thickdiff (new axis arg, so its columns run through the plate)
    shows 0.00 mm3 off-wall. Only single wall-grazing columns differ.
    Rejected hand-fitting each profile the way the Eye Adaptor was done.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
2026-10-14 Fork as a native solid; linkage rebuild documented
    The Fork's 133 non-plate triangles all lie on 0.949 r + 0.316 y = 8.5, which is
    a 0.5 x 1.5 chamfer on the outer edge. It is built as a Fusion chamfer feature,
    not a revolved or extruded cut, so it stays editable. The builder flips the
    two-distance order if the read-back radius is wrong, because the API doesn't
    document which face gets which distance. Every vertex is within 0.0001 mm and
    thickdiff is 0.00 mm3 off-wall.
    profile2d: a turn limit inside arcs. A rectangle's corners are concyclic, so
    the Fork's arm ends fit a perfect "arc". The four plate profiles regenerate
    identically with the guard.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
2026-10-14 Constrain and dimension every native sketch (fcad.constrain_all)
    A greedy pass that leaves the geometry where it is:
    - horizontal/vertical lines
    - tangency where curves meet smoothly
    - centers onto the origin or onto each other
    - Equal on arcs whose radii agree to 0.0002 mm
    - a radius or diameter on every round
    - then horizontal/vertical distances from the sketch origin to any point still free
    The solver rejects a redundant constraint, so that step is skipped, and the
    order always ends fully constrained.
    constrain_docs.py ran it in place on the six saved designs:
    - every sketch is fully constrained
    - volume moved at most 5 ppm (tangency closing fit noise)
    - every vertex still within 0.0006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
2026-10-14 Assembly placements for every kit part, fitted against Complete Model
    register.py matches each part STL to its shell in Complete Model (volume +
    extents, inertia start, ICP); placements.py pins each occurrence to a clean
    motion (identity / +75 copy / lid rotation about X / X-normal plate) and fits
    only the free parameters. Results in hardware/native/placements.json.
    Rejected assuming the part STLs are already in the assembly frame: Complete
    Model is the parts rotated +90 deg about X, the Y-Arm sits 45.2 mm off in x,
    and the lids are posed (+24.5 / -26.3 deg). Rejected taking the model's right
    eye as-is: it is the left eye MIRRORED about x = 37.5, which no print of the
    one (x2) Eye Adaptor S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
2026-10-14 Sub Base native: spec file + generic Fusion builder, checked offline first
    hardware/native/specs/sub_base.py lists the part as axis-aligned extrusions plus two chamfer features.
    tools/meshcad/xcsg.py builds that list with manifold3d and subtracts the STL both ways, so a spec is
    proved before Fusion sees it (Sub Base: 0.69 mm3 missing / 0.21 extra, all facet slivers at arcs).
    hardware/native/spec_native.py builds the same list in Fusion, constrains every sketch, checks the
    STL vertices (max 0.0002 mm, 15 sketches fully constrained, 87 dimensions), saves "Sub Base native"
    to the hub folder and exports the .f3d.
    Rejected writing a per-part Fusion script as for the Fork and plates: each MCP ite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
2026-10-14 Eye Holder native: U plate + bar, vertex max 0.0005 mm
    The bar is a y extrusion whose bottom follows the plate's R2 inner fillets, with the plan taper cut
    afterwards. Rejected the z-extruded trapezoid with a flat bottom: simpler, but it missed the STL by
    0.0054 mm where the bar fills the fillet notch, i.e. it was not how the part was made.
    Not modeled: the STL's top holes narrow to R1.5 for their last 0.0002 mm, a zero-thickness ring
    from overlapping source features. Specs can now name EXEMPT boxes with a reason; spec_native leaves
    those vertices out of the check and prints how many boxes were used.
2026-10-14 Main Base native: back plate, four pivot arms, gussets, upper block, servo posts
    41 sketches fully constrained (225 dimensions); every STL vertex within 0.0002 mm;
    thickdiff off-wall -0.29 mm3 (hole chords). Saved to the hub folder as "Main Base native".
    The outer arms' 1 mm chamfer is a real Fusion chamfer (spec_native now takes `pick`
    points and chamfers the tangent chain), not cuts: its end against the gusset plane
    falls out of Fusion's own termination and matched the mesh to 0.0002 mm, where the
    CSG stand-in needed an extra "stop" wedge to reproduce it.
    The mesh carries a hairline wedge (0.032 mm at z 25, closing at z 34.06) between the
    block's bottom chamfer and the plate face: a seam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
2026-10-14 Servo Block native: plate, walls, feet, rod/screw holes, traced logo
    18 sketches fully constrained (112 dimensions); every STL vertex within 0.0001 mm;
    thickdiff off-wall +0.29 mm3. Saved to the hub folder as "Servo Block native".
    The Nilheim logo is three fixed fitted splines through the mesh's own cap vertices
    (tools/meshcad/caploops.py -> profiles/servo_block_logo.json), not lines and arcs:
    profile2d's arc fits on it left 0.003 mm residuals, over the 0.002 check, and a
    dimension on each of ~290 points would be noise, not design intent. Edit it as
    artwork. Spec features gain `runs` (line or spline per corner-to-corner run) in
    xcsg.py, spec_native.py and fcad.Builder.runs_loop.
    Every cut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
2026-10-14 Top Left Lid native: tilted-frame spec, revolved shell, Move back to the STL frame
    The lid's lip planes sit 20 deg about the pivot (x). Drawn in the turned frame (rotstl.py decodes there) and
    turned back with one Move feature (spec FRAME), so every sketch is axis-aligned and dimensioned plainly.
    Rejected sketching on tilted construction planes: 16 sketches each on its own angled plane, and every
    dimension then reads in a skewed frame Scott would have to un-skew to edit.
    Shell is a full-turn revolve of an (r, w) half-section about the bore axis (new Builder.revolve +
    spec revolve loop=); xcsg already revolved, Fusion could not. The bore pocket's curved floor is built
    as the R1 cut plus an an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
2026-10-14 Top Right Lid native: the Top Left spec mirrored z' -> -z', frame turn reversed
    mircmp: the kit's Top Right Lid is the Top Left with STL z negated, 0.0000 mm.
    specs/_mirror.py mirrors a FEATURES list across a drawing-frame plane (arcs
    reverse, lo/hi swap along the mirror axis, revolve half-sections flip w), so
    every dimension stays in top_left_lid.py and both lids follow an edit.
    Fusion: 16 sketches all constrained, 7309 vertices max 0.0012 mm.
    Rejected a Fusion Mirror feature on a built left lid: it would make the right
    lid's sketches the left lid's (no sketch of its own to edit), and xcsg would
    need a mirror op it doesn't model. Rejected copying the spec with signs
    flipped by hand: two co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
2026-10-14 Bottom Left Lid native: two drawing frames, and an exact Move
    The bottom lid is a union built in two frames: the shell and an inner ring at
    20 deg (like the top lids), the lip ring, ears and tab at 18.47655 deg. Specs
    get a mid-sequence op="rotate" (xcsg turns the manifold, spec_native adds a
    Move; _mirror negates it). Rejected separate bodies plus a combine: one body
    throughout keeps spec_native's one-body assert and the same feature list for xcsg.
    Rejected one 'best' frame with a single tilted bore: the bore's triangles show
    two walls (vertical above z' 2.06, 1.52 deg below), and a one-cylinder fit left
    0.006 mm.
    fcad.rotate_body now moves by an exact matrix (defineAsFreeMove):
    defineAsRo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
2026-10-14 Bottom Right Lid native: the Bottom Left mirrored in z, reload _mirror
    Built from bottom_left_lid via _mirror.mirror(..., "z"); FRAME and the rotate
    op's angle negate. Fusion: max 0.0012 mm over 6945 vertices, 14 sketches all
    fully constrained, 57 dimensions; vol 2.3117 cm3. Saved to the hub folder and
    exported as hardware/native/Bottom Right Lid native.f3d.
    The first build came out 0.087 mm off: Fusion's Python had kept the _mirror
    module from an earlier run, from before mirror() learned to negate rotate ops.
    Both mirrored specs now importlib.reload(_mirror). Rejected deleting the
    module from sys.modules in spec_native instead: the reload sits next to the
    import it protects, so a new mirro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
2026-10-14 PlaceHolder Eye native: sector revolves, tilted offset-axis shell
    Native rebuild of the kit's PlaceHolder Eye from specs/placeholder_eye.py via
    spec_native.py. It is the eyeball (R15, bore 11.990381, keying rib, three snap
    recesses) inside an R16 shell. Fusion: vol 7.4562 cm3, 7 sketches all
    constrained, 38 dimensions, all 11,497 STL vertices within 0.0001 mm.
    thickdiff -12.76 mm3 overall, -3.24 off-wall in cells of <=0.003 mm3; the rest
    is wall columns (bore, recess walls) and the R16 silhouette chorded by the
    export mesh.
    The shell keeps the STL's quirks: a 0.0278 deg tilt about +Y, its back plane at
    7.493136, and rings that are R16 arcs about an axis offset 0.0087 mm, not a
    sphere. Repro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
2026-10-14 EyeMech assembly: 20 occurrences referencing the 15 hub natives
    assembly_native.py inserts every placements.json occurrence with
    addByInsert(..., isReferencedComponent=True), so an edit to a native part
    shows up in the assembly. Copying the parts in was rejected because Scott
    wants to edit the linkages, and copies would freeze them. Saved to the hub
    as "EyeMech assembly", with Main Base grounded.
    Check (AS_CHECK=10): each kit STL's vertices, moved by its placement, measured
    against that occurrence's body in place. Max 0.0001-0.0012 mm on 19 of 20,
    matching each part's own gate. Eye Holder reads 0.25 at a point inside its
    spec's EXEMPT ring box. The first check, the assembly's exported STL a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
2026-10-14 EyeMech assembly: joints so the eyes and lids move
    joints_native.py adds as-built revolutes to the hub assembly:
    - Tilt: Sub Base + Eye Holder on the Main Base pins.
    - Pan L/R: each Eye Adaptor + Fork + eye on the Eye Holder's vertical pin, linked 1:1.
    - Four lids on the Main Base pins.
    - The connector, Y-Arm and lid links pinned at their mechanism end and motion-linked to counter-rotate.
    The pivots come from the placed parts' coaxial cylinders.
    Verified by driving:
    - The right Fork's tail pin stays within 0.0005 mm of the connector hole.
    - The coupler slides match 2*r*sin(theta/2).
    - Every pose returns to home.
    Rejected alternatives:
    - A per-eye U-joint at the Fork lugs. The Fork meets th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
2026-10-14 EyeMech assembly: joint limits from measured collisions
    limits_native.py sweeps a joint out from home until Fusion's interference analysis finds any overlap, bisecting to
    0.1 deg. The hub assembly now carries these limits:
    - Pan: -44.8..+41.9 (the eye reaches the Eye Holder).
    - Tilt: -32.3..+29.5.
    - Lids: closed where both lids of an eye meet; open where both can open together at any pan.
    100 corner poses are clear, each value read back from its joint.
    - Limits from the kit's servo numbers. The horns are not modelled, so commands don't map to angles.
    - A limit box with no collision anywhere. Eyes-down with the top lids open puts the Three-Point Connector into the
    to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
2026-10-14 Add the six SG90 servos and horns to the EyeMech assembly
    SG90 and SG90 Horn are native specs decoded from Complete Model.stl (the kit
    ships no servo STL), simplified as bought parts with GATE_MM 0.11.
    servo_placements.py fits all six from geometry; servos_native.py mounts each
    servo rigid to its measured holder, puts each horn on a revolute and
    motion-links mechanism -> horn at the solved four-bar ratio. Saved to the hub.
    Rejected:
    - Ordered (Procrustes) fit of the servos: the right-hand copies are mirrored
    meshes with their own triangle order; frames are read off geometry instead.
    - Keeping the CM's right lid horn angles (+-20 deg): 6.7 and 7.1 mm off the
    right links. Turned to close;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
2026-10-14 Noise test on the page: one servo, all, or hold, repeated for 30 s
    Scott wants to find which noise source is loudest before changing hardware
    (shoulder bolts were the first idea). A fixed, repeatable motion lets a
    sound meter compare runs: one servo out half travel and back with the other
    five full-off, all six moving, or all six holding still. Eased or sudden.
    - Driving single channels by raw pulse values: the motion goes through the
    kit math via a Frame instead, so trims, centers and limits still apply and
    nothing can be commanded past what the eyes already do.
    - Testing to full travel or the closed lid: end stops and the closed seal
    make a servo strain and buzz, which wou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
2026-10-26 Flash dumps out of git; say where they live now
    History was rewritten (git filter-repo) to purge backup/*.bin, because a
    full-chip read includes NVS and the 09-28 dump held the IoT Wi-Fi
    passphrase. Deleting at HEAD was rejected: going public publishes history.
    Force-pushing over the old repo was rejected too: GitHub keeps serving
    orphaned commits by SHA, and old build IDs are quoted all over CLAUDE.md, so
    the scrubbed history went to a fresh repo and the old one is kept private as
    animatronic-eyes-prescrub.
